SeaFlightGlider/seaflight-mechanical/Parts List.txt

BD-ASY-0348-0000 BUOYANCY ENGINE HYDRAULIC SCHEMATIC
BD-ASY-0360-0000 BUOYANCY ENGINE ASSEMBLY
BD-ASY-0359-0000 RESERVOIR ASSEMLBY
BD-ASY-0357-0000 BUOYANCY ENGINE CHASSIS ASSEMBLY
BD-ASY-0355-0000 MOUNT, FLIGHT WORKS MOTOR
BD-ASY-0354-0000 HOUSING, BLADDER,75 CU IN DISPLACMENT DIAPHRAGM
BD-PRT-0297-0000 CHASSIS, BUOYANCY ENGINE
BD-PRT-0298-0000 ENDCAP, BUOYANCY ENGINE
BD-PRT-0299-0000 HOUSING, BUOYANCY ENGINE
BD-PRT-0300-0000 RESERVOIR CHASSIS, BUOYANCY ENGINE
