SeaFlightGlider/seaflight-mechanical/Step Files/BD-ASY-0359-0002_RevD.stp

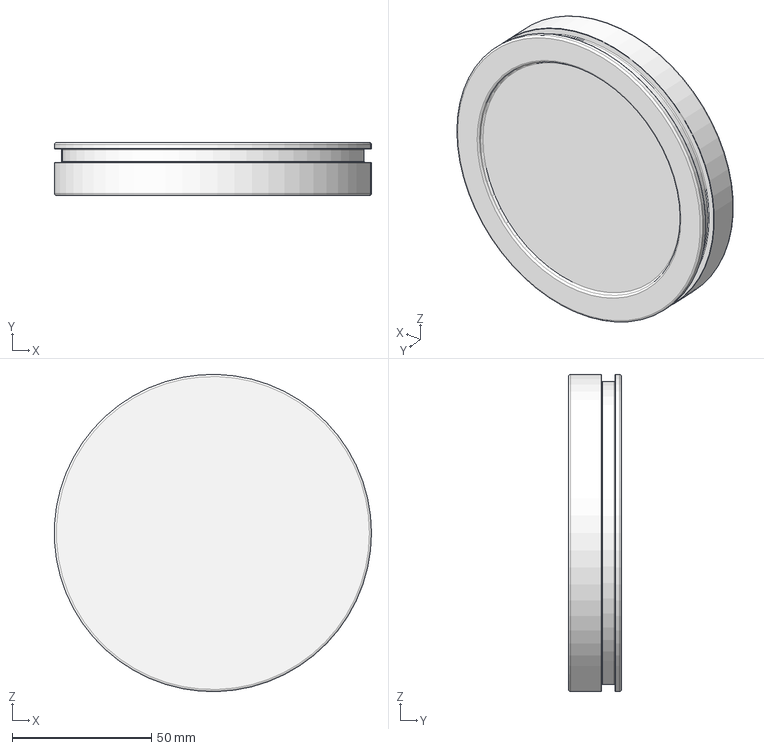
[picture p1: CAD file, 2021-02-25]
Step Files/BD-ASY-0359-0002_RevD.stp
113.8 x 19.1 x 113.9 mm
