SeaFlightGlider/seaflight-mechanical/Step Files/BD-PRT-0308-0000_RevA.stp

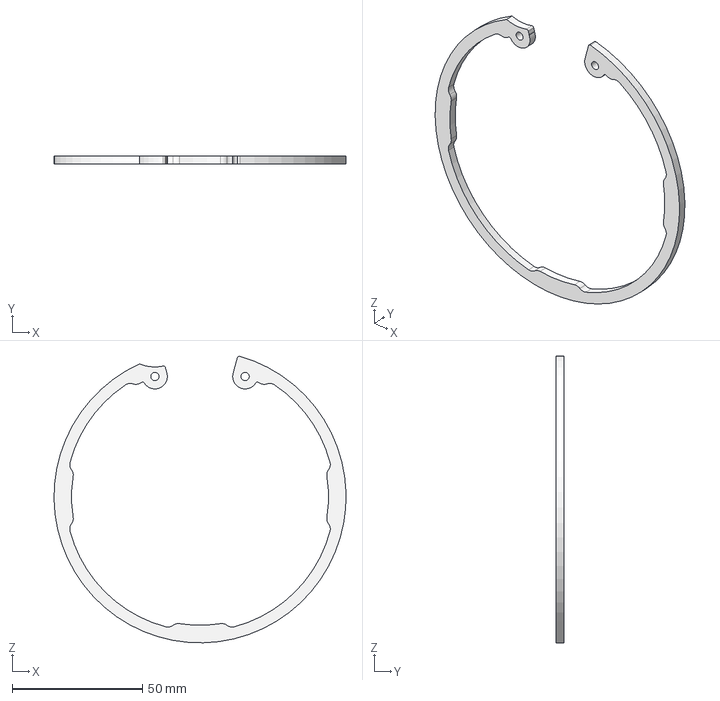
[picture p3: CAD file, 2021-02-25]
Step Files/BD-PRT-0308-0000_RevA.stp
111.9 x 3.17 x 109.9 mm
