SeaFlightGlider/seaflight-mechanical/Step Files/BD-PRT-0297-0000_RevC.stp

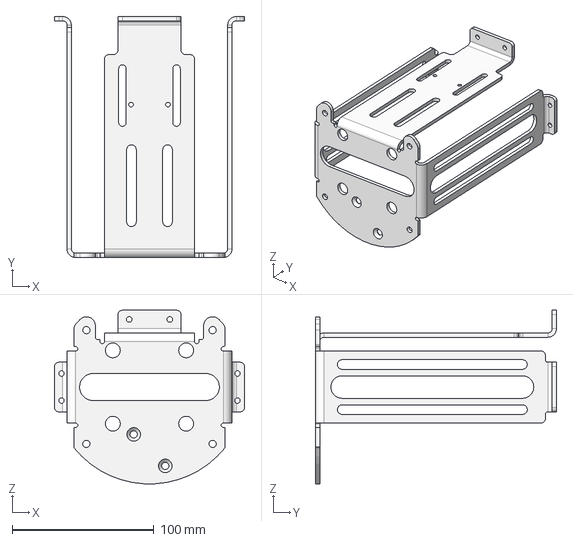
[picture p4: CAD file, 2021-02-25]
Step Files/BD-PRT-0297-0000_RevC.stp
133.9 x 169.7 x 122.2 mm
