SeaFlightGlider/seaflight-mechanical/Step Files/BD-ASY-0354-0001_RevB.stp

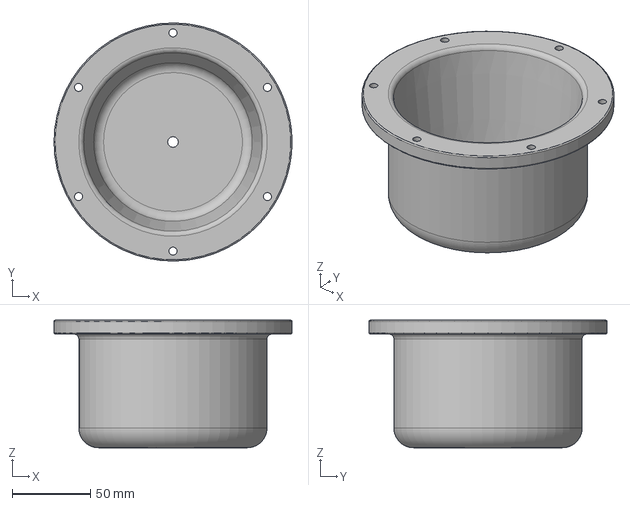
[picture p5: CAD file, 2021-02-25]
Step Files/BD-ASY-0354-0001_RevB.stp
152.4 x 152.4 x 81.7 mm
