SeaFlightGlider/seaflight-mechanical/Step Files/BD-ASY-0359-0001_RevD.stp

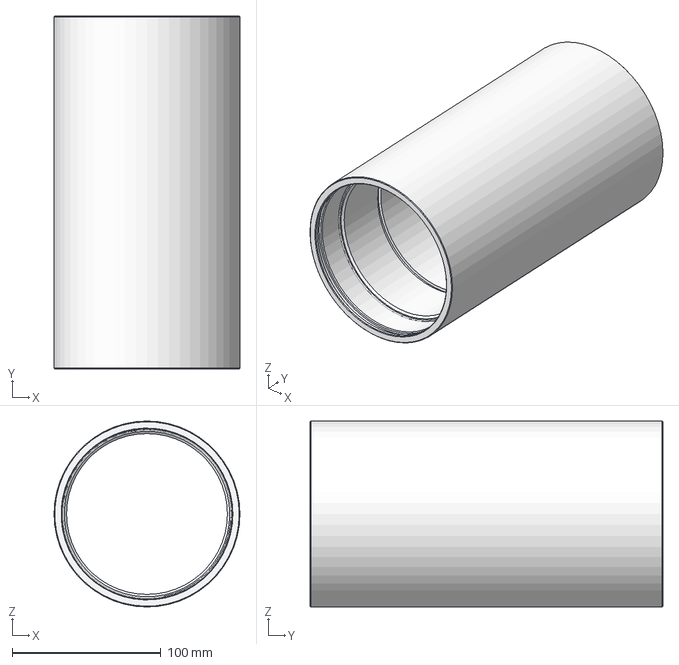
[picture p8: CAD file, 2021-02-25]
Step Files/BD-ASY-0359-0001_RevD.stp
124.8 x 236.9 x 124.8 mm
