SeaFlightGlider/seaflight-mechanical/Step Files/BD-PRT-0299-0000_RevB.stp

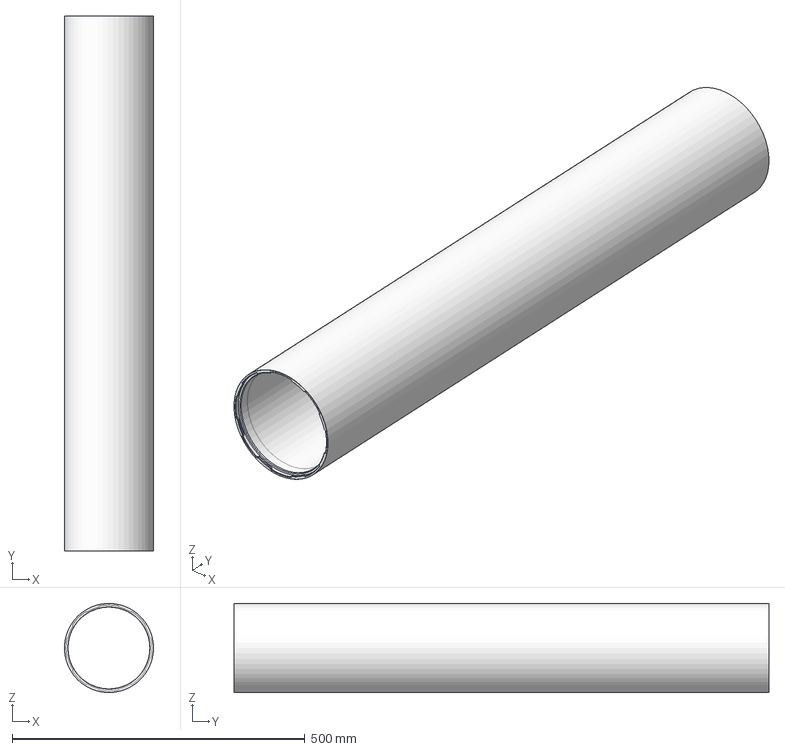
[picture p10: CAD file, 2021-02-25]
Step Files/BD-PRT-0299-0000_RevB.stp
152.3 x 914.4 x 152.3 mm
