SeaFlightGlider/seaflight-mechanical/Step Files/BD-ASY-0355-0001_RevA.stp

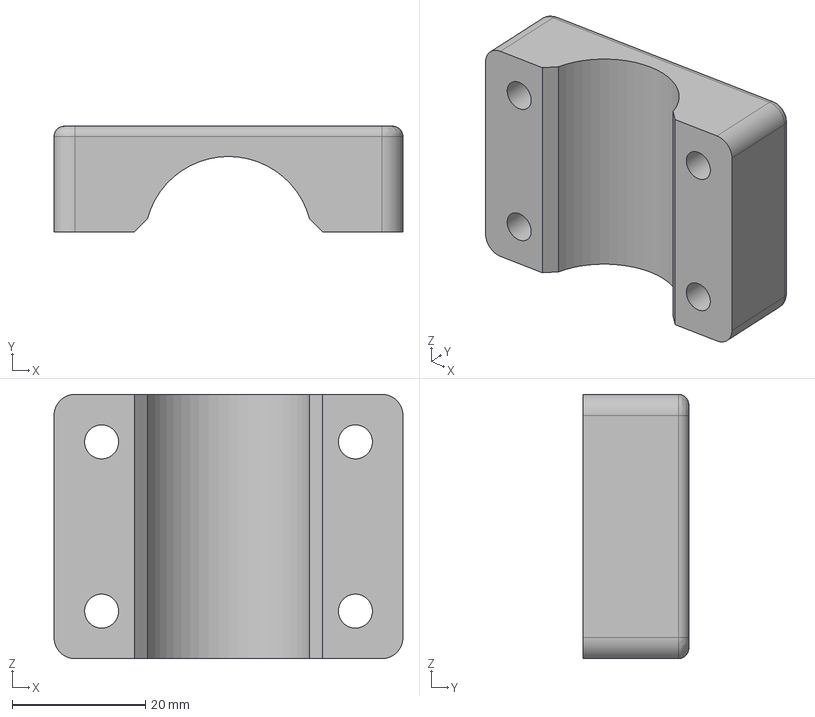
[picture p11: CAD file, 2021-02-25]
Step Files/BD-ASY-0355-0001_RevA.stp
52.4 x 15.9 x 39.7 mm
