SeaFlightGlider/seaflight-mechanical/Step Files/BD-PRT-0307-0000_RevA.stp

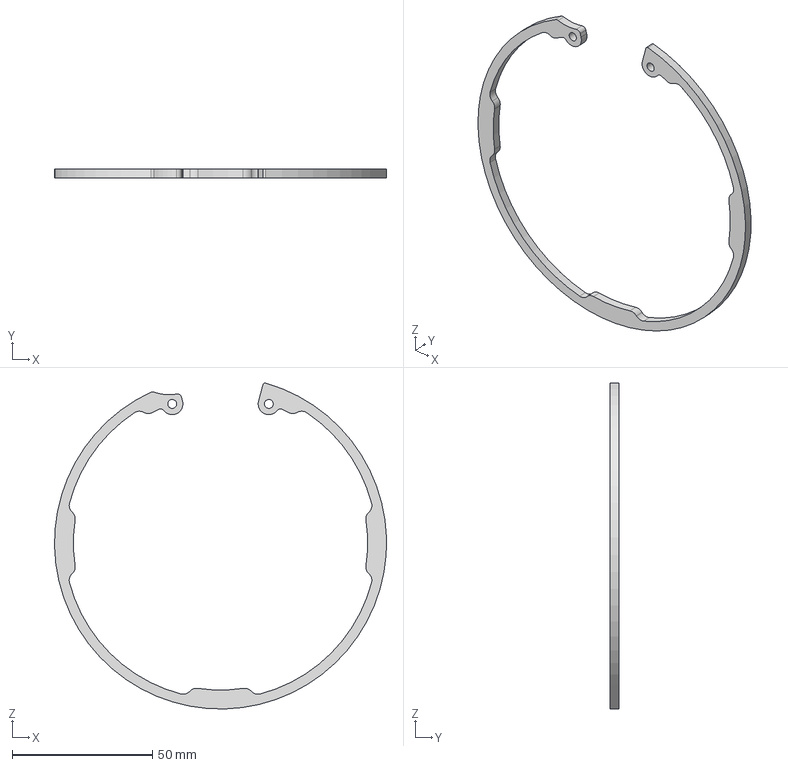
[picture p12: CAD file, 2021-02-25]
Step Files/BD-PRT-0307-0000_RevA.stp
118.3 x 3.17 x 116.1 mm
