SeaFlightGlider/seaflight-mechanical/Step Files/BD-ASY-0359-0003_RevD.stp

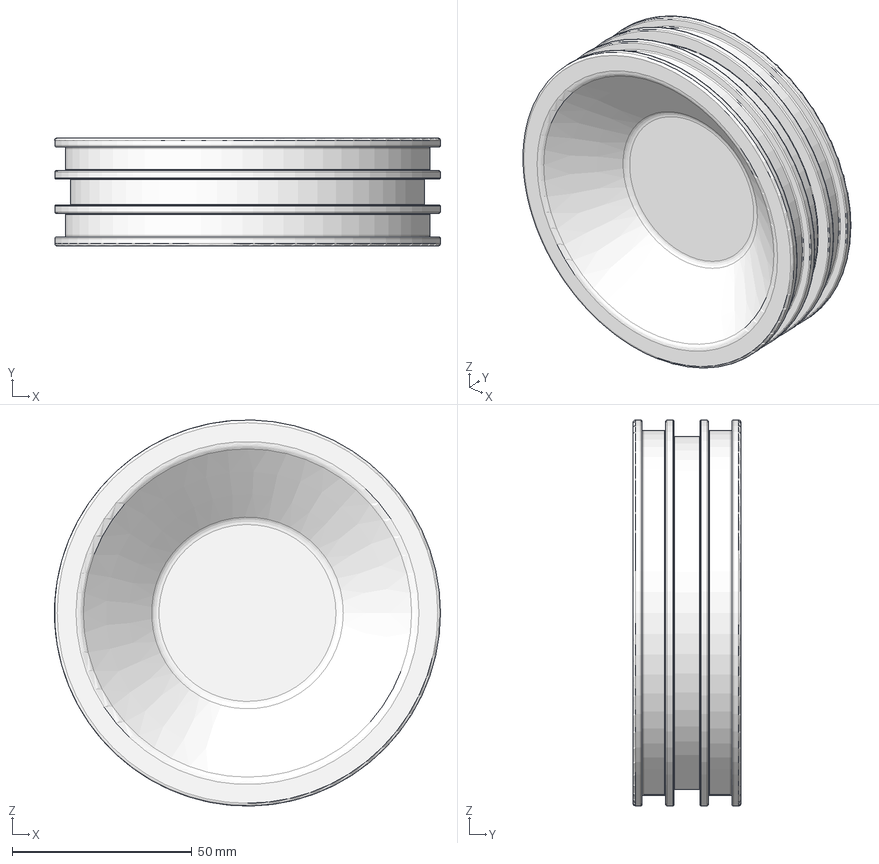
[picture p13: CAD file, 2021-02-25]
Step Files/BD-ASY-0359-0003_RevD.stp
107.5 x 30.2 x 107.5 mm
