SeaFlightGlider/seaflight-mechanical/Step Files/BD-PRT-0298-0002_RevE.stp

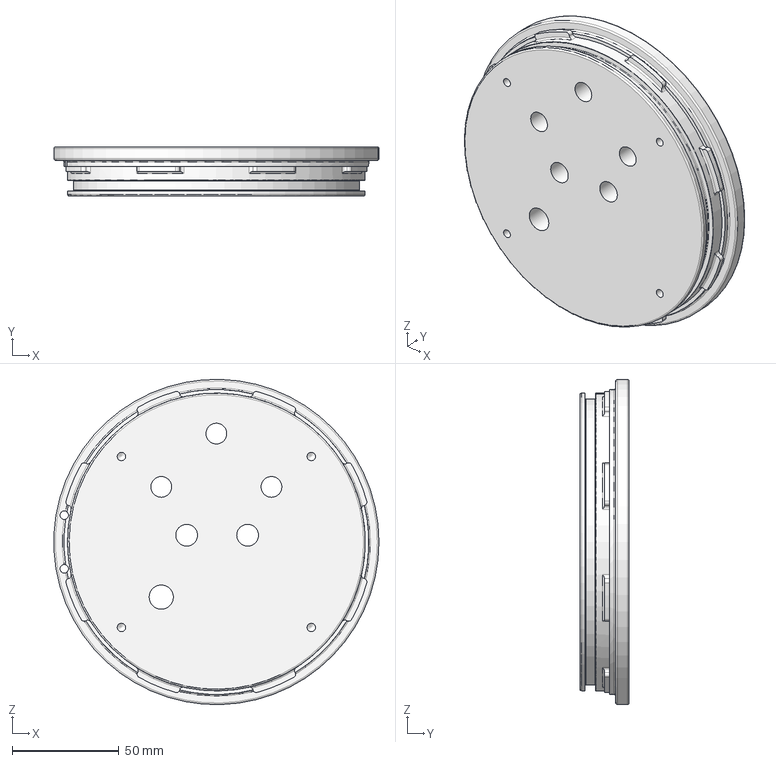
[picture p15: CAD file, 2021-02-25]
Step Files/BD-PRT-0298-0002_RevE.stp
152.3 x 23.2 x 152.3 mm
