SeaFlightGlider/seaflight-mechanical/Step Files/BD-PRT-0300-0000_RevB.stp

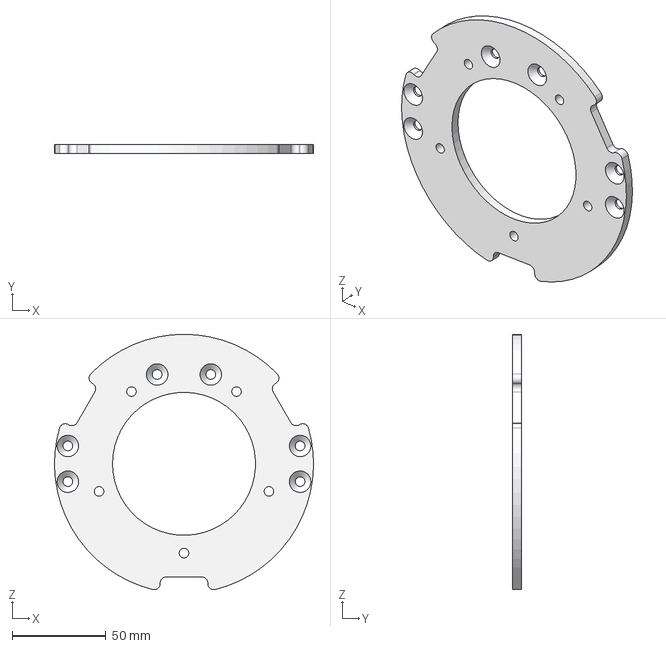
[picture p16: CAD file, 2021-02-25]
Step Files/BD-PRT-0300-0000_RevB.stp
138.1 x 4.76 x 136.2 mm
