SeaFlightGlider/seaflight-mechanical/(list of files, cad)

Other CAD files:
Step Files/BD-PRT-0307-0000_RevA.dxf
Step Files/BD-PRT-0308-0000_RevA.dxf
