SeaFlightGlider/seaflight-mechanical/BD-ASY-0348-0000_RevC.pdf

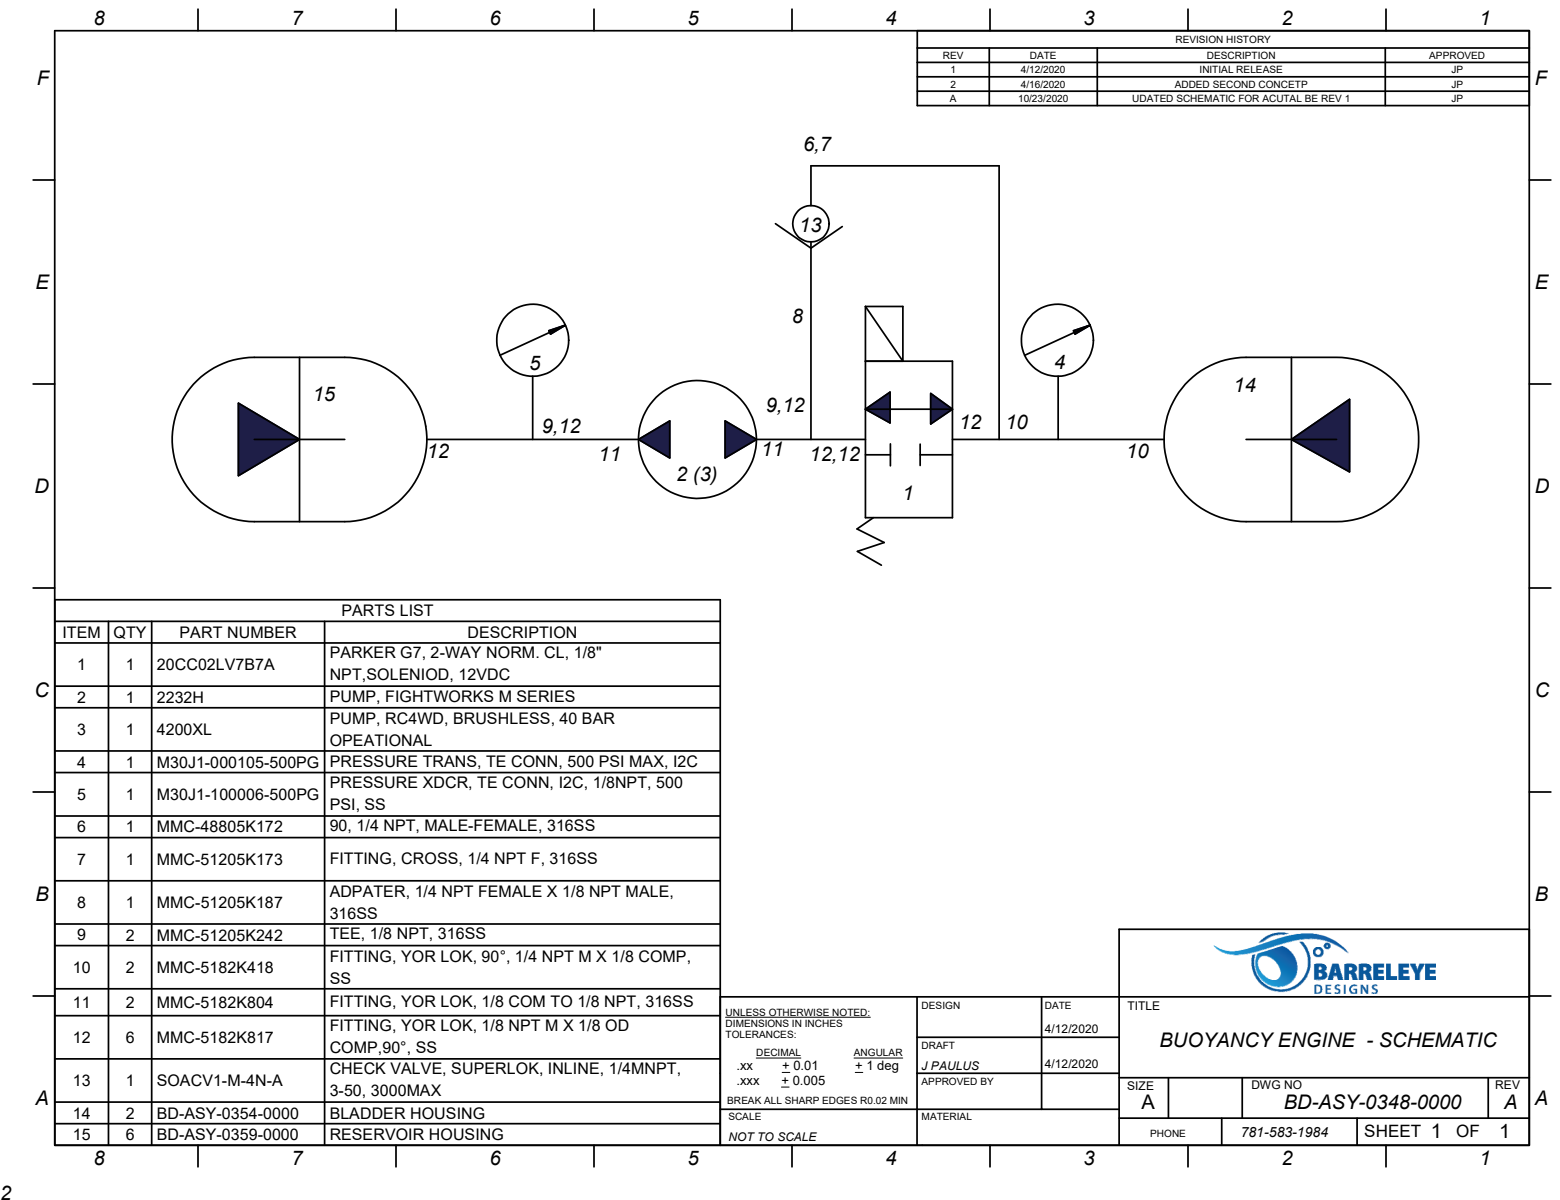
[picture p17: page 1]
DESIGN; DECIMAL; ANGULAR; + 1 deg; DATE; PARTS LIST; REVISION HISTORY

REV | DATE | DESCRIPTION | APPROVED
1 | 4/12/2020 | INITIAL RELEASE | JP
2 | 4/16/2020 | ADDED SECOND CONCETP | JP
A | 10/23/2020 | UDATED SCHEMATIC FOR ACUTAL BE REV 1 | JP

ITEM | QTY | PART NUMBER | DESCRIPTION
1 | 1 | 20CC02LV7B7A | PARKER G7, 2-WAY NORM. CL, 1/8" NPT,SOLENIOD, 12VDC

2 | 1 | 2232H | PUMP, FIGHTWORKS M SERIES
3 | 1 | 4200XL | PUMP, RC4WD, BRUSHLESS, 40 BAR OPEATIONAL

4 | 1 | M30J1-000105-500PG | PRESSURE TRANS, TE CONN, 500 PSI MAX, I2C
5 | 1 | M30J1-100006-500PG | PRESSURE XDCR, TE CONN, I2C, 1/8NPT, 500 PSI, SS

6 | 1 | MMC-48805K172 | 90, 1/4 NPT, MALE-FEMALE, 316SS
7 | 1 | MMC-51205K173 | FITTING, CROSS, 1/4 NPT F, 316SS
8 | 1 | MMC-51205K187 | ADPATER, 1/4 NPT FEMALE X 1/8 NPT MALE, 316SS

9 | 2 | MMC-51205K242 | TEE, 1/8 NPT, 316SS
10 | 2 | MMC-5182K418 | FITTING, YOR LOK, 90°, 1/4 NPT M X 1/8 COMP, SS

11 | 2 | MMC-5182K804 | FITTING, YOR LOK, 1/8 COM TO 1/8 NPT, 316SS

UNLESS OTHERWISE NOTED:

TITLE
BUOYANCY ENGINE - SCHEMATIC

12 | 6 | MMC-5182K817 | FITTING, YOR LOK, 1/8 NPT M X 1/8 OD COMP,90°, SS | DIMENSIONS IN INCHES TOLERANCES: .xxx + 0.005 BREAK ALL SHARP EDGES R0.02 MIN

DRAFT J PAULUS | 4/12/2020

13 | 1 | SOACV1-M-4N-A | CHECK VALVE, SUPERLOK, INLINE, 1/4MNPT, 3-50, 3000MAX

APPROVED BY | | SIZE A | DWG NO BD-ASY-0348-0000 | REV A

14 | 2 | BD-ASY-0354-0000 | BLADDER HOUSING
15 | 6 | BD-ASY-0359-0000 | RESERVOIR HOUSING

SCALE NOT TO SCALE | MATERIAL
PHONE | 781-583-1984 | SHEET 1 OF 1
