SeaFlightGlider/seaflight-mechanical/BD-ASY-0354-0000_RevB.pdf

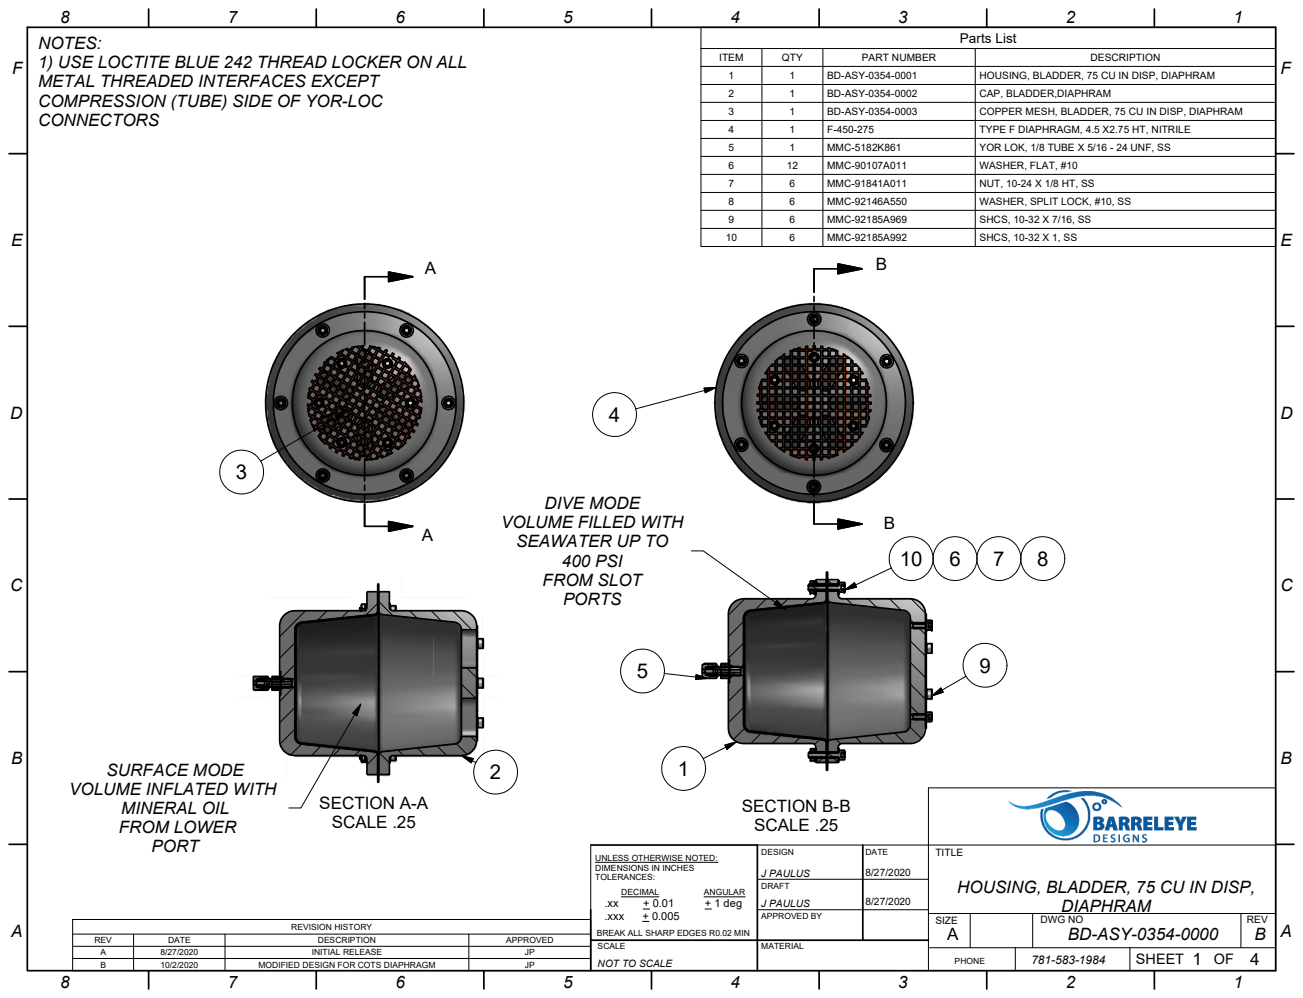
[picture p18: page 1]
SECTION A-A SCALE .25; SECTION B-B SCALE .25; SHEET; DESIGN; DECIMAL; ANGULAR; + 1 deg; .xxx; MATERIAL; DATE; DIAPHRAM; J PAULUS; NOT TO SCALE; PHONE; Parts List; REVISION HISTORY; INITIAL RELEASE; MODIFIED DESIGN FOR COTS DIAPHRAGM

NOTES:
1) USE LOCTITE BLUE 242 THREAD LOCKER ON ALL
METAL THREADED INTERFACES EXCEPT
COMPRESSION (TUBE) SIDE OF YOR-LOC
CONNECTORS

ITEM | QTY | PART NUMBER | DESCRIPTION
1 | 1 | BD-ASY-0354-0001 | HOUSING, BLADDER, 75 CU IN DISP, DIAPHRAM
2 | 1 | BD-ASY-0354-0002 | CAP, BLADDER,DIAPHRAM
3 | 1 | BD-ASY-0354-0003 | COPPER MESH, BLADDER, 75 CU IN DISP, DIAPHRAM
4 | 1 | F-450-275 | TYPE F DIAPHRAGM, 4.5 X2.75 HT, NITRILE
5 | 1 | MMC-5182K861 | YOR LOK, 1/8 TUBE X 5/16 - 24 UNF, SS
6 | 12 | MMC-90107A011 | WASHER, FLAT, #10
7 | 6 | MMC-91841A011 | NUT, 10-24 X 1/8 HT, SS
8 | 6 | MMC-92146A550 | WASHER, SPLIT LOCK, #10, SS
9 | 6 | MMC-92185A969 | SHCS, 10-32 X 7/16, SS
10 | 6 | MMC-92185A992 | SHCS, 10-32 X 1, SS

DIVE MODE
VOLUME FILLED WITH
SEAWATER UP TO
400 PSI
FROM SLOT
PORTS

SURFACE MODE
VOLUME INFLATED WITH
MINERAL OIL
FROM LOWER
PORT

UNLESS OTHERWISE NOTED:
DIMENSIONS IN INCHES
TOLERANCES:

TITLE
HOUSING, BLADDER, 75 CU IN DISP,

DRAFT J PAULUS | 8/27/2020

APPROVED BY | | SIZE A | DWG NO BD-ASY-0354-0000 | REV B

REV | DATE | DESCRIPTION | APPROVED

BREAK ALL SHARP EDGES R0.02 MIN
SCALE

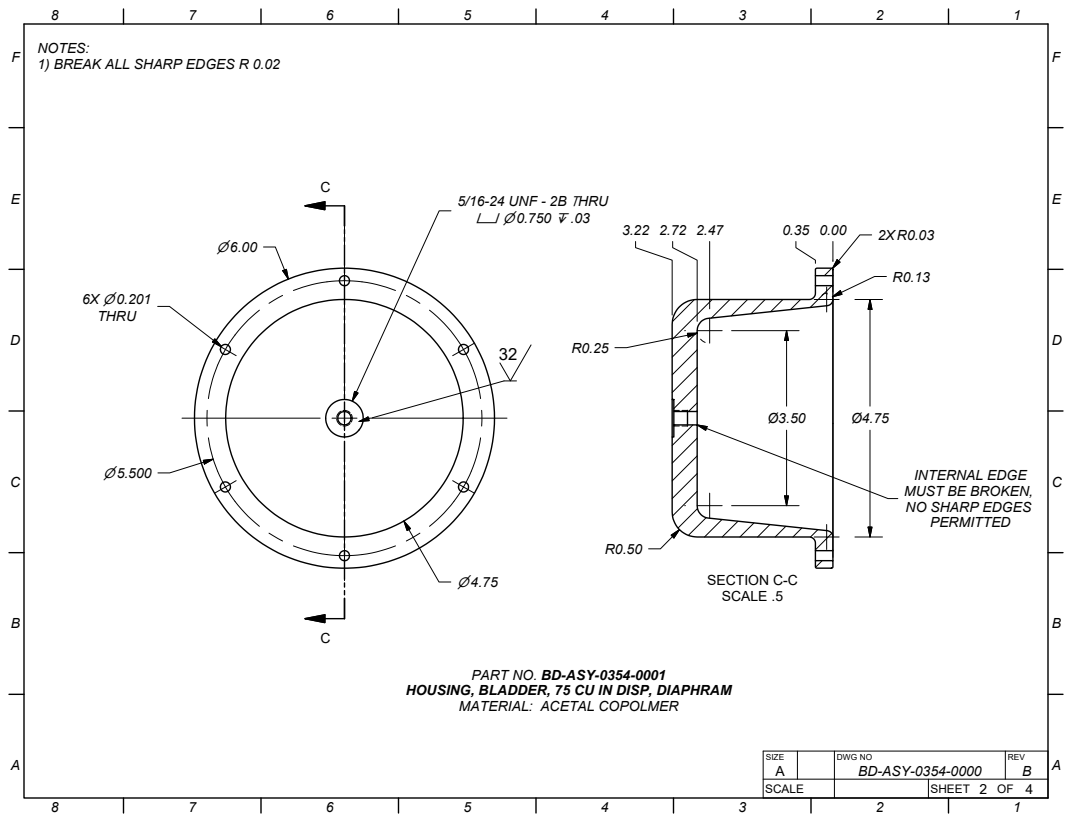
[picture p19: page 2]
SECTION C-C SCALE .5; 5/16-24 UNF - 2B HRU 0.750 .03; 6X 0.201 THRU

1) BREAK ALL SHARP EDGES R 0.02

INTERNAL EDGE
MUST BE BROKEN,
NO SHARP EDGES
PERMITTED

PART NO. BD-ASY-0354-0001

HOUSING, BLADDER, 75 CU IN DISP, DIAPHRAM

MATERIAL: ACETAL COPOLMER

SIZE | DWG NO | REV

SCALE | SHEET OF

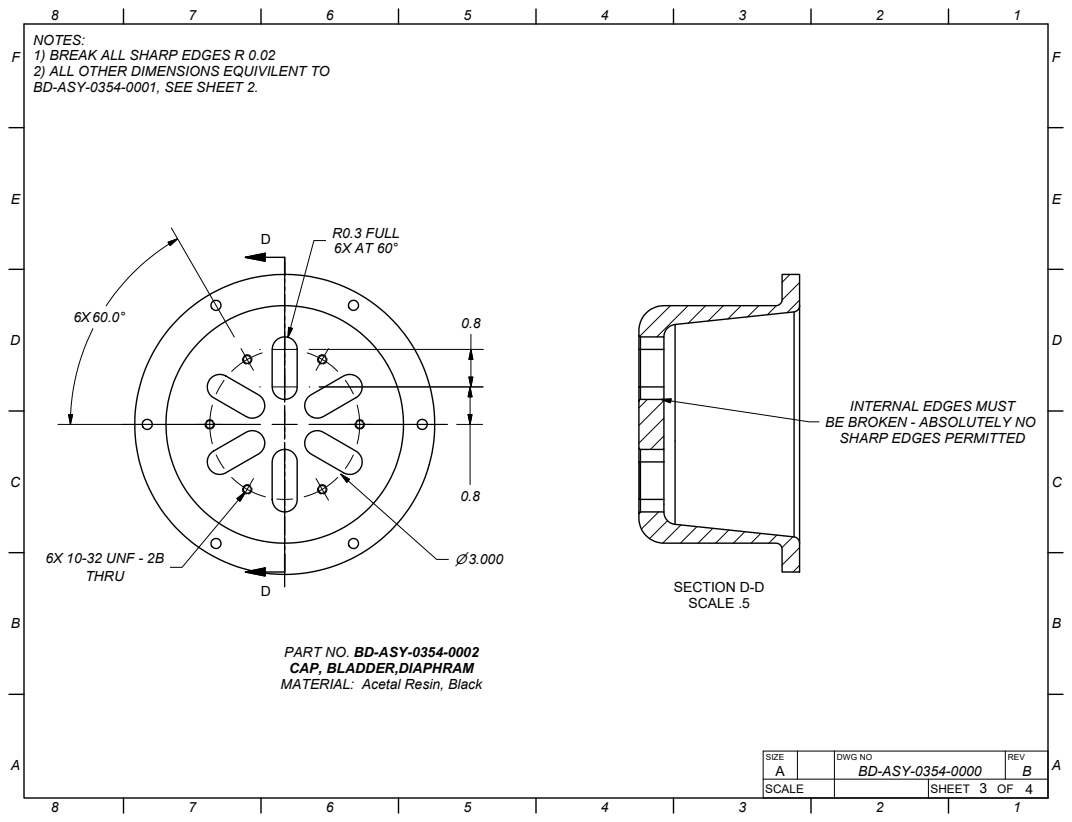
[picture p20: page 3]
SECTION D-D SCALE .5; SIZE; DWG NO; REV; R0.3 FULL 6X AT 60°; 6X 10-32 UNF - 2B; THRU

1) BREAK ALL SHARP EDGES R 0.02
2) ALL OTHER DIMENSIONS EQUIVILENT TO
BD-ASY-0354-0001, SEE SHEET 2.

INTERNAL EDGES MUST
BE BROKEN - ABSOLUTELY NO
SHARP EDGES PERMITTED

PART NO. BD-ASY-0354-0002
CAP, BLADDER,DIAPHRAM
MATERIAL: Acetal Resin, Black

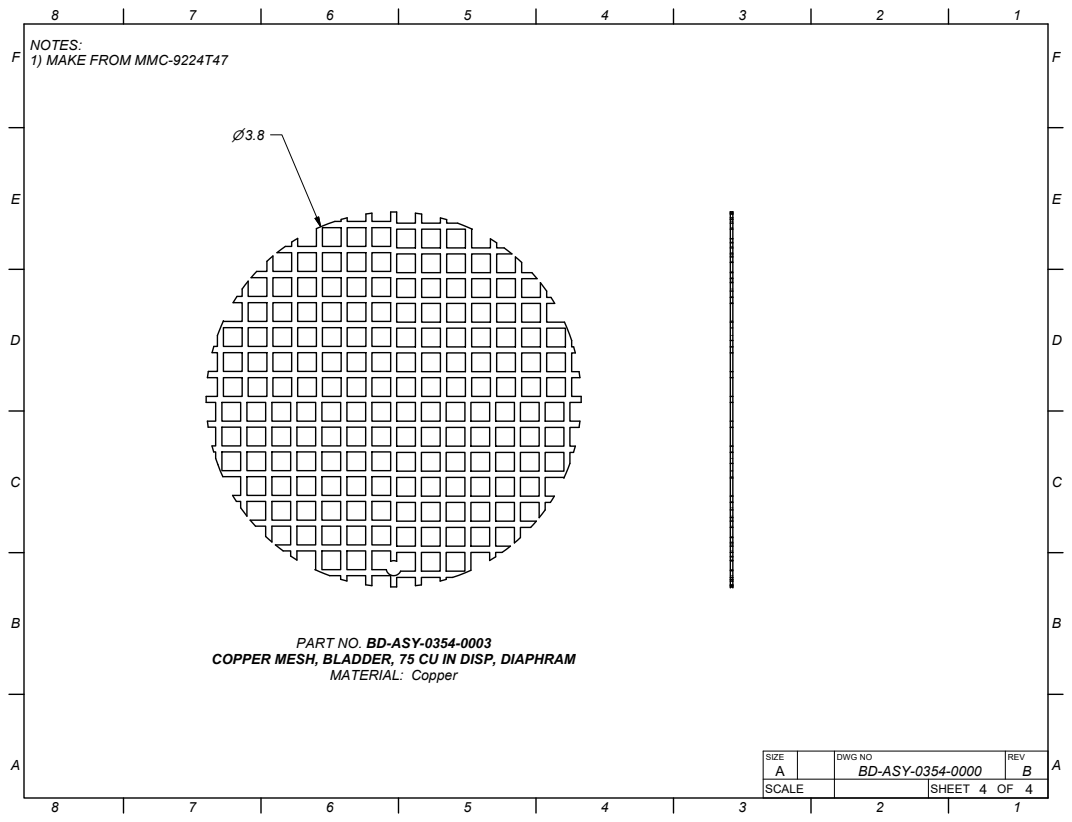
[picture p21: page 4]
MATERIAL: Copper; SIZE; DWG NO; REV

1) MAKE FROM MMC-9224T47

PART NO. BD-ASY-0354-0003

COPPER MESH, BLADDER, 75 CU IN DISP, DIAPHRAM
