SeaFlightGlider/seaflight-mechanical/BD-ASY-0355-0000_RevA.pdf

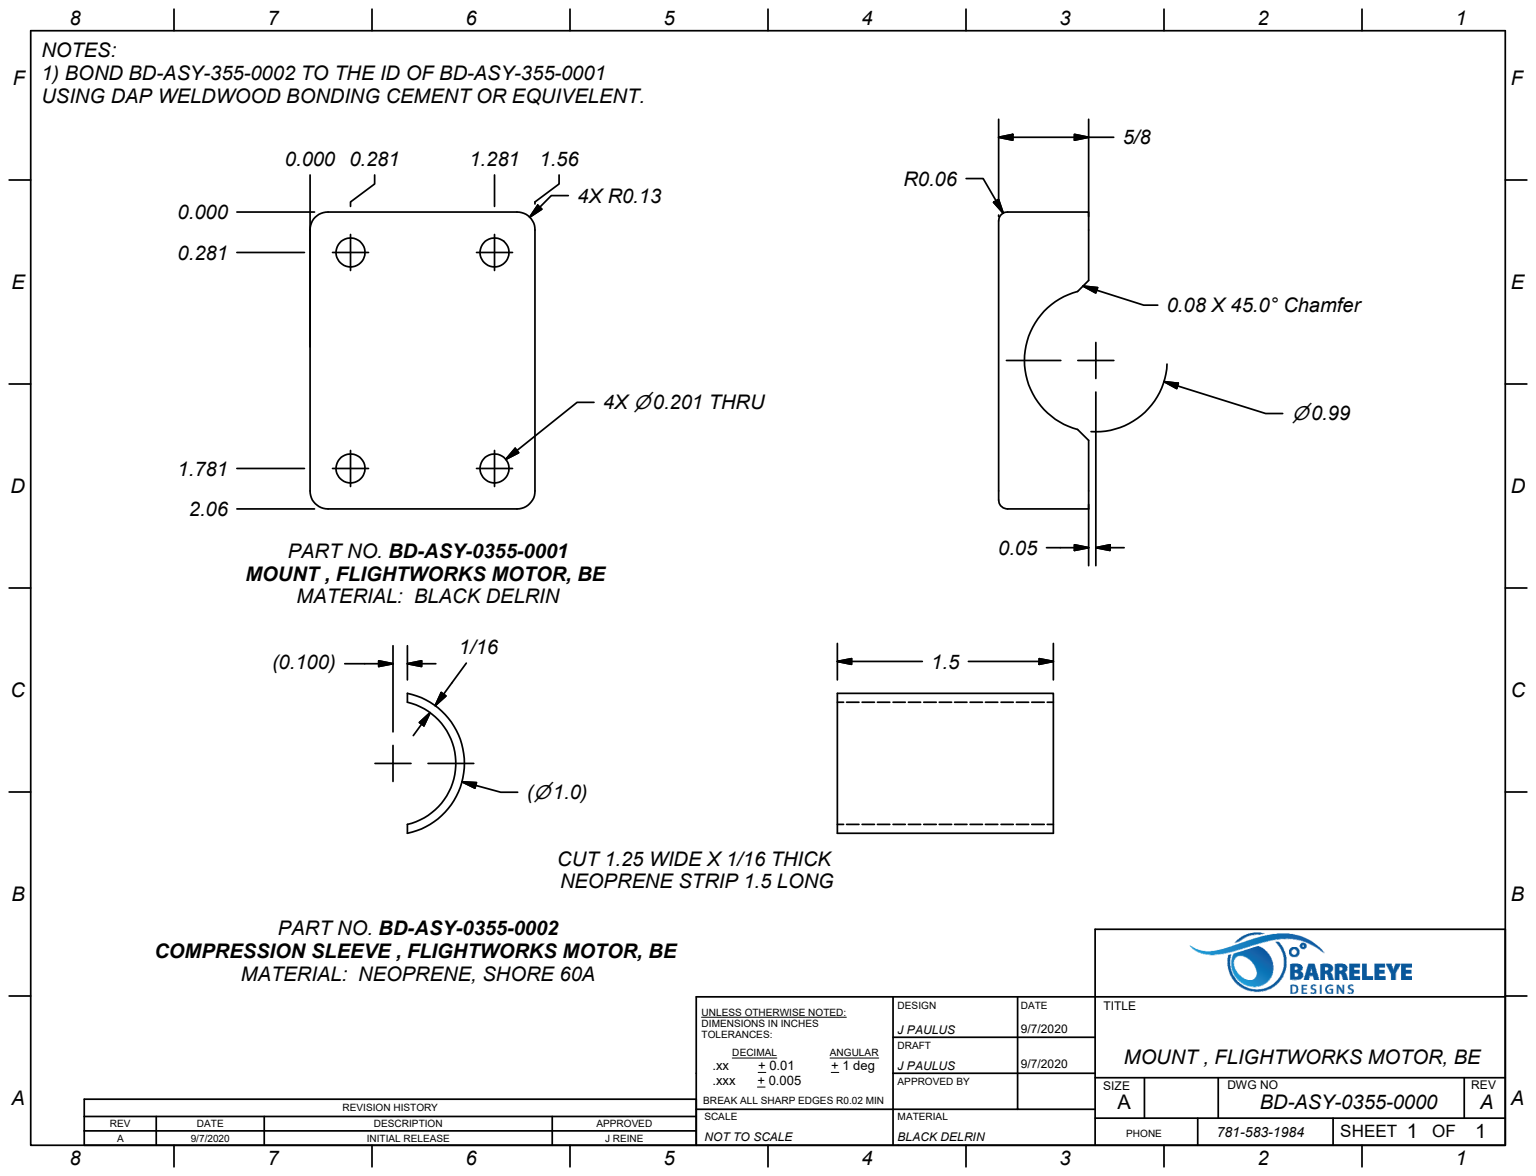
[picture p22: page 1]
SHEET; DESIGN; TITLE; DECIMAL; ANGULAR; + 1 deg; .xxx; MATERIAL; DATE; J PAULUS; BLACK DELRIN; NOT TO SCALE; PHONE; REVISION HISTORY; REV; DESCRIPTION; APPROVED; INITIAL RELEASE; J REINE; 0.08 X 45.0° Chamfer; THRU 0.201

NOTES:
1) BOND BD-ASY-355-0002 TO THE ID OF BD-ASY-355-0001
USING DAP WELDWOOD BONDING CEMENT OR EQUIVELENT.

PART NO. BD-ASY-0355-0001
MOUNT , FLIGHTWORKS MOTOR, BE
MATERIAL: BLACK DELRIN

CUT 1.25 WIDE X 1/16 THICK
NEOPRENE STRIP 1.5 LONG

PART NO. BD-ASY-0355-0002

COMPRESSION SLEEVE , FLIGHTWORKS MOTOR, BE

MATERIAL: NEOPRENE, SHORE 60A

UNLESS OTHERWISE NOTED:
DIMENSIONS IN INCHES
TOLERANCES:

DRAFT J PAULUS | 9/7/2020

APPROVED BY | | SIZE A | DWG NO BD-ASY-0355-0000 | REV A

BREAK ALL SHARP EDGES R0.02 MIN
SCALE
