SeaFlightGlider/seaflight-mechanical/BD-ASY-0357-0000_RevC.pdf

1

2

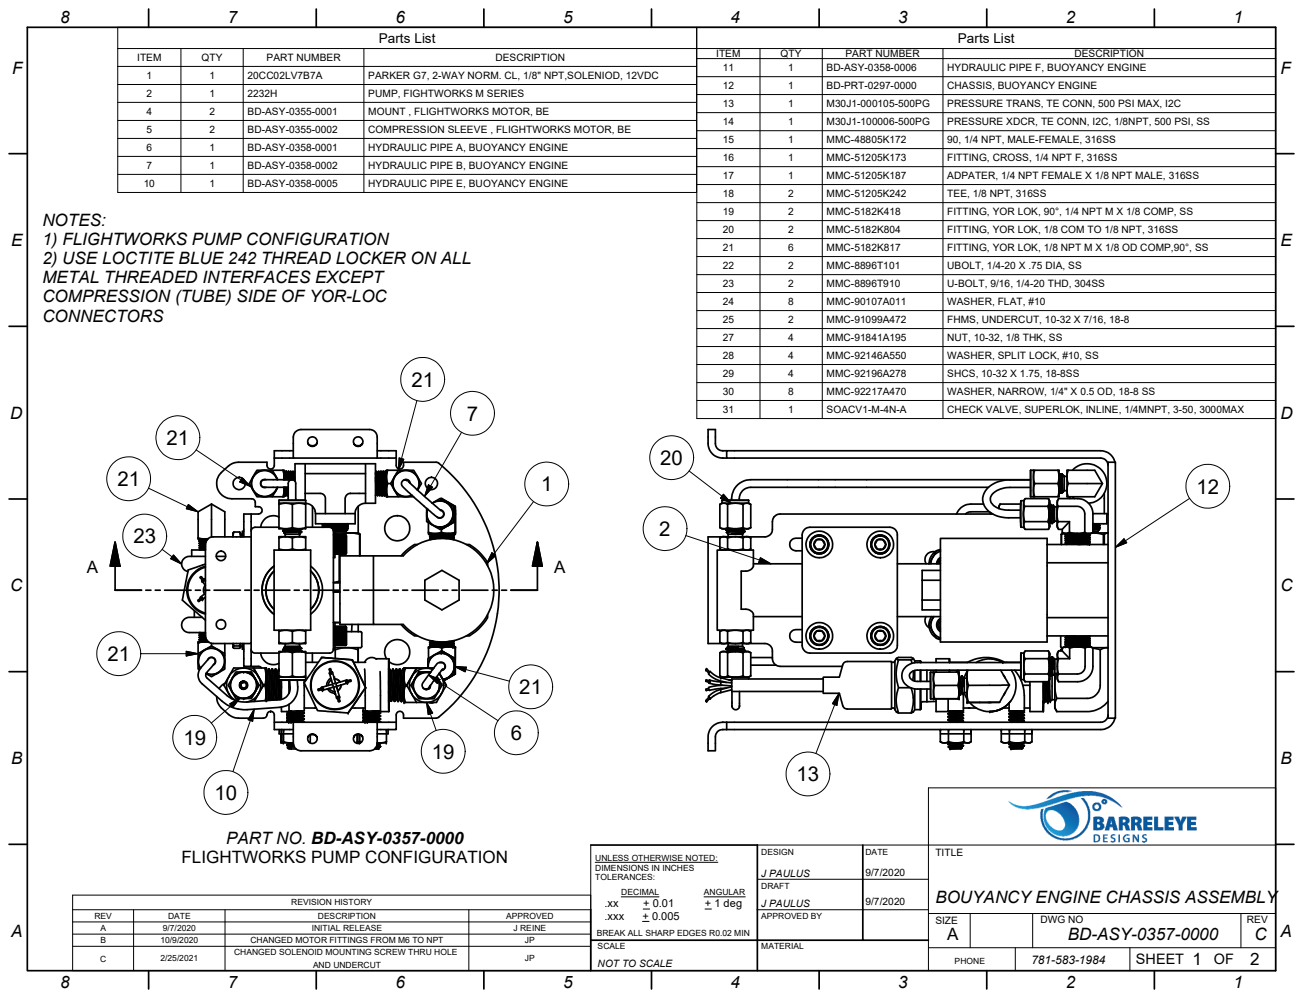
[picture p23: page 1]
SIZE; DWG NO; REV; SHEET; DESIGN; APPROVED BY; TITLE; DRAFT; DECIMAL; ANGULAR; + 1 deg; .xxx; MATERIAL; DATE; BD-ASY-0357-0000; J PAULUS; NOT TO SCALE; PHONE; Parts List; ITEM; QTY; PART NUMBER; DESCRIPTION; PARKER G7, 2-WAY NORM. CL, 1/8" NPT,SOLENIOD, 12VDC; PUMP, FIGHTWORKS M SERIES; BD-ASY-0355-0001; MOUNT , FLIGHTWORKS MOTOR, BE; BD-ASY-0355-0002; COMPRESSION SLEEVE , FLIGHTWORKS MOTOR, BE; BD-ASY-0358-0001; HYDRAULIC PIPE A, BUOYANCY ENGINE; BD-ASY-0358-0002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

NOTES:
1) FLIGHTWORKS PUMP CONFIGURATION
2) USE LOCTITE BLUE 242 THREAD LOCKER ON ALL
METAL THREADED INTERFACES EXCEPT
COMPRESSION (TUBE) SIDE OF YOR-LOC
CONNECTORS

PART NO. BD-ASY-0357-0000
FLIGHTWORKS PUMP CONFIGURATION

UNLESS OTHERWISE NOTED:
DIMENSIONS IN INCHES
TOLERANCES:

BOUYANCY ENGINE CHASSIS ASSEMBLY

BREAK ALL SHARP EDGES R0.02 MIN
SCALE

## SECTION A-A

SCALE .5 | SECTION B-B

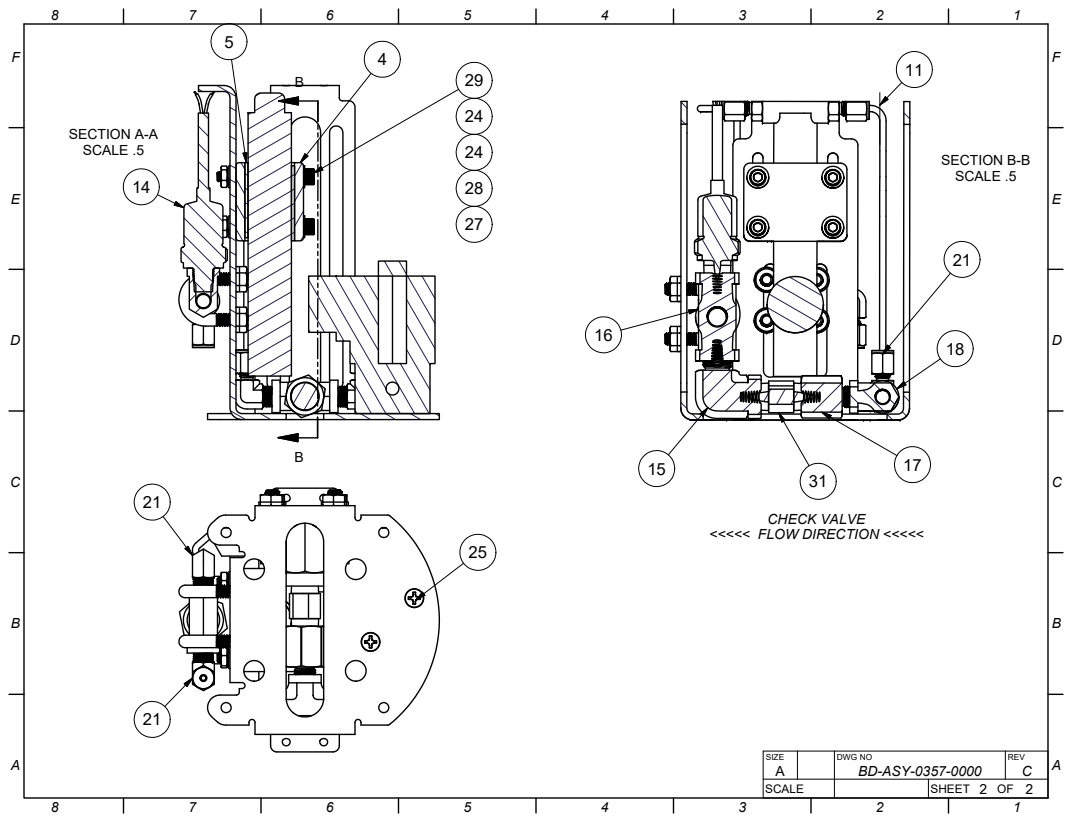
[picture p24: page 2]
SCALE .5; SIZE; DWG NO; REV; SCALE; SHEET; BD-ASY-0357-0000; CHECK VALVE <<<<< FLOW DIRECTION <<<<<
