SeaFlightGlider/seaflight-mechanical/BD-ASY-0359-0000_RevD.pdf

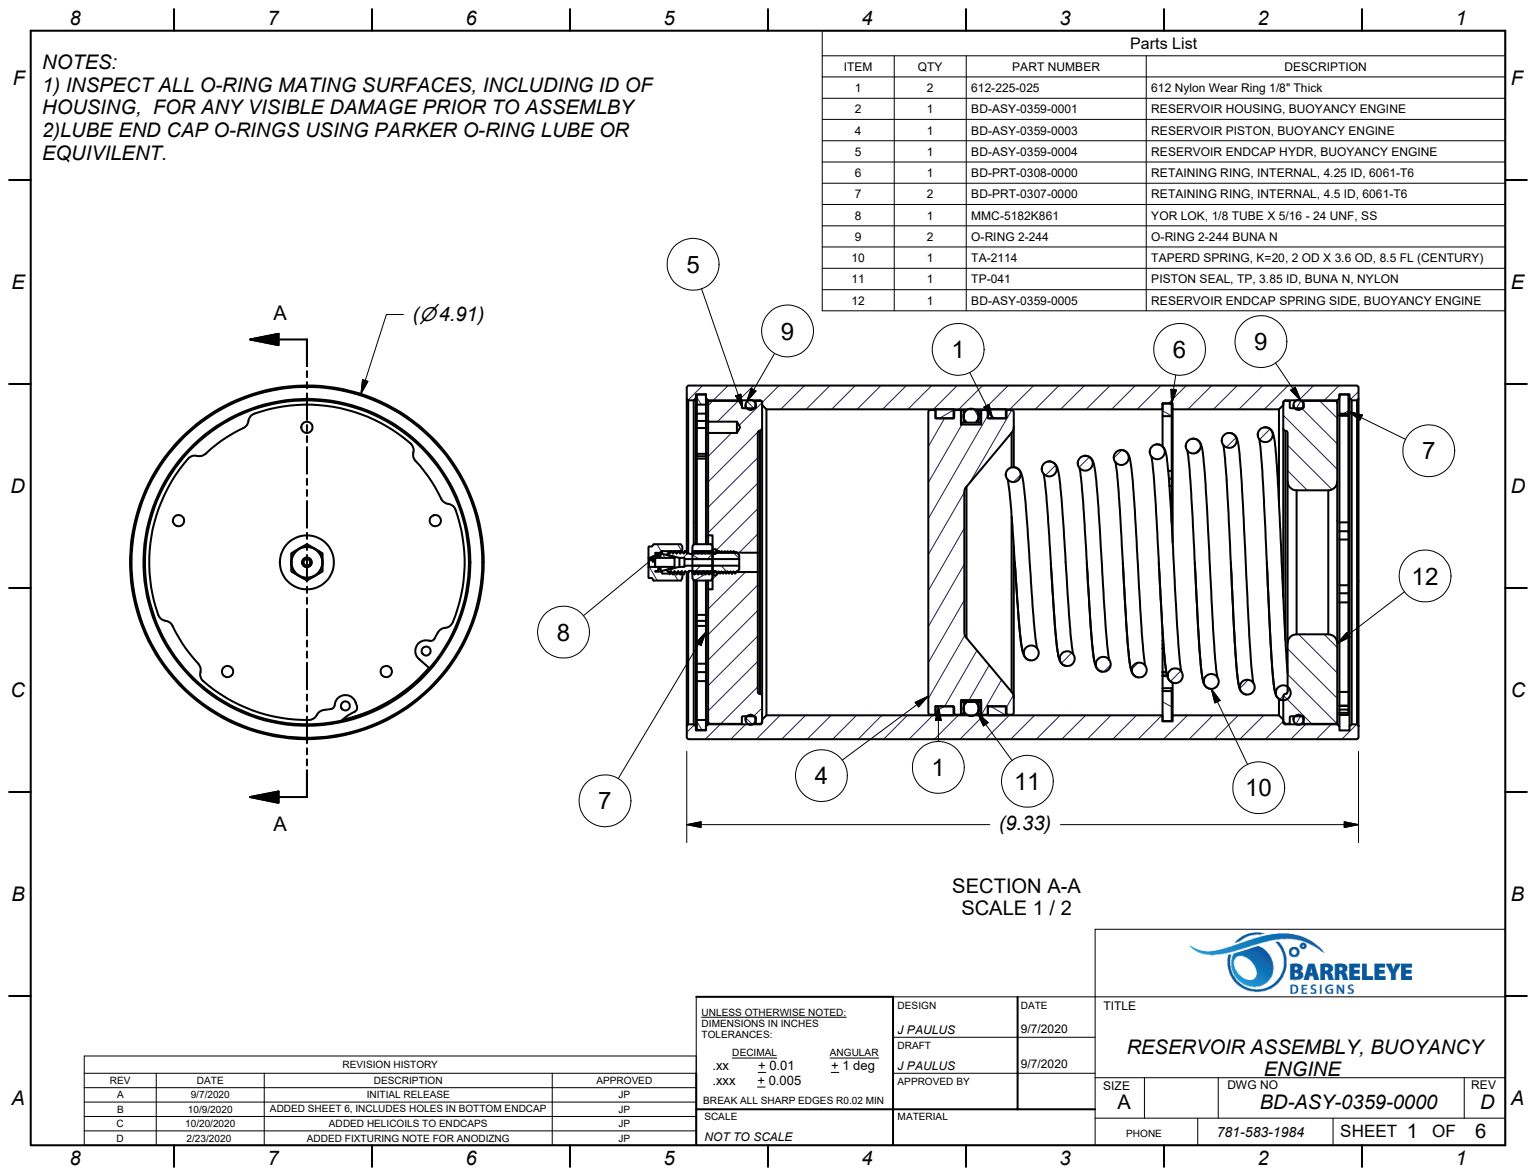
[picture p25: page 1]
SECTION A-A SCALE 1 / 2; SIZE; DWG NO; REV; SHEET; DESIGN; APPROVED BY; DRAFT; DECIMAL; ANGULAR; + 1 deg; .xxx; MATERIAL; DATE; ENGINE BD-ASY-0359-0000; J PAULUS; NOT TO SCALE; PHONE; Parts List; BD-ASY-0359-0005; RESERVOIR ENDCAP SPRING SIDE, BUOYANCY ENGINE ( 4.91); REVISION HISTORY; DESCRIPTION; APPROVED; ADDED HELICOILS TO ENDCAPS; ADDED FIXTURING NOTE FOR ANODIZNG

NOTES:
1) INSPECT ALL O-RING MATING SURFACES, INCLUDING ID OF
HOUSING, FOR ANY VISIBLE DAMAGE PRIOR TO ASSEMLBY
2)LUBE END CAP O-RINGS USING PARKER O-RING LUBE OR
EQUIVILENT.

ITEM | QTY | PART NUMBER | DESCRIPTION
1 | 2 | 612-225-025 | 612 Nylon Wear Ring 1/8" Thick
2 | 1 | BD-ASY-0359-0001 | RESERVOIR HOUSING, BUOYANCY ENGINE
4 | 1 | BD-ASY-0359-0003 | RESERVOIR PISTON, BUOYANCY ENGINE
5 | 1 | BD-ASY-0359-0004 | RESERVOIR ENDCAP HYDR, BUOYANCY ENGINE
6 | 1 | BD-PRT-0308-0000 | RETAINING RING, INTERNAL, 4.25 ID, 6061-T6
7 | 2 | BD-PRT-0307-0000 | RETAINING RING, INTERNAL, 4.5 ID, 6061-T6
8 | 1 | MMC-5182K861 | YOR LOK, 1/8 TUBE X 5/16 - 24 UNF, SS
9 | 2 | O-RING 2-244 | O-RING 2-244 BUNA N
10 | 1 | TA-2114 | TAPERD SPRING, K=20, 2 OD X 3.6 OD, 8.5 FL (CENTURY)
11 | 1 | TP-041 | PISTON SEAL, TP, 3.85 ID, BUNA N, NYLON

UNLESS OTHERWISE NOTED:
DIMENSIONS IN INCHES
TOLERANCES:

TITLE
RESERVOIR ASSEMBLY, BUOYANCY

A | 9/7/2020 | INITIAL RELEASE | JP
B | 10/9/2020 | ADDED SHEET 6, INCLUDES HOLES IN BOTTOM ENDCAP | JP

BREAK ALL SHARP EDGES R0.02 MIN
SCALE

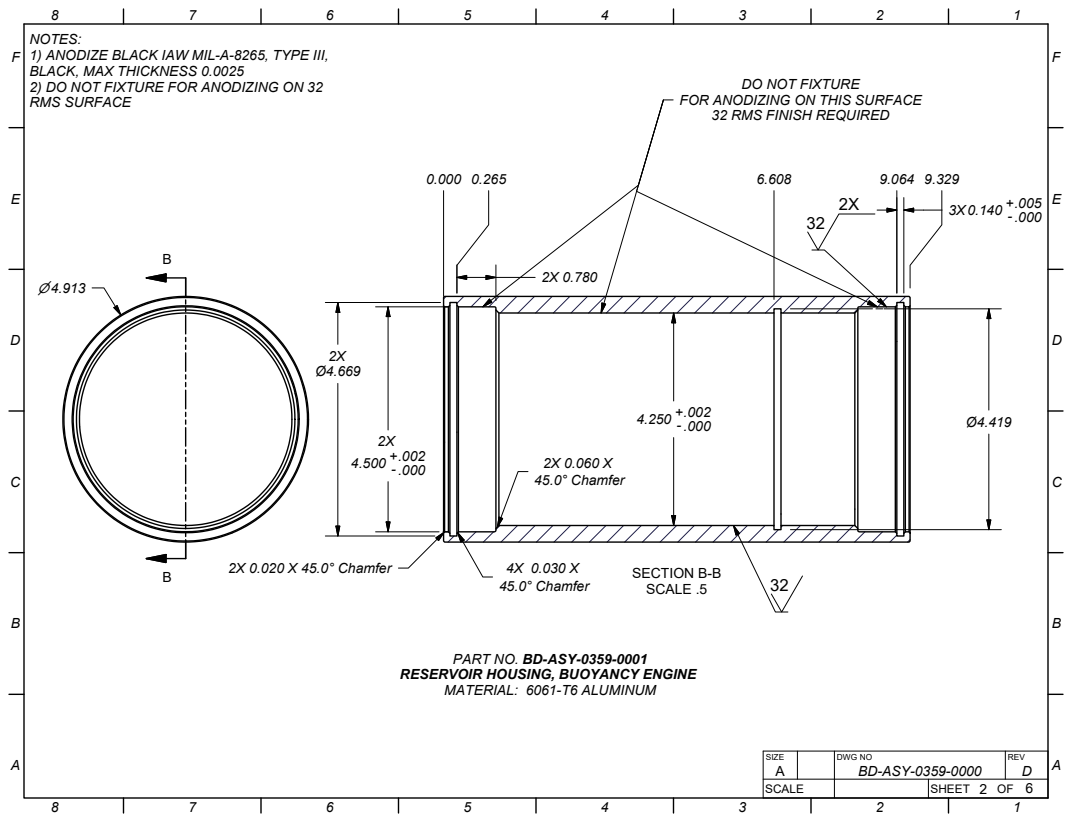
[picture p26: page 2]
SECTION B-B SCALE .5; 2X 0.060 X 45.0° Chamfer; 4X 0.030 X 45.0° Chamfer; 2X 0.020 X 45.0° Chamfer

1) ANODIZE BLACK IAW MIL-A-8265, TYPE III,
BLACK, MAX THICKNESS 0.0025
2) DO NOT FIXTURE FOR ANODIZING ON 32
RMS SURFACE

DO NOT FIXTURE

FOR ANODIZING ON THIS SURFACE
32 RMS FINISH REQUIRED

PART NO. BD-ASY-0359-0001

RESERVOIR HOUSING, BUOYANCY ENGINE
MATERIAL: 6061-T6 ALUMINUM

SIZE | DWG NO | REV

SCALE | SHEET OF

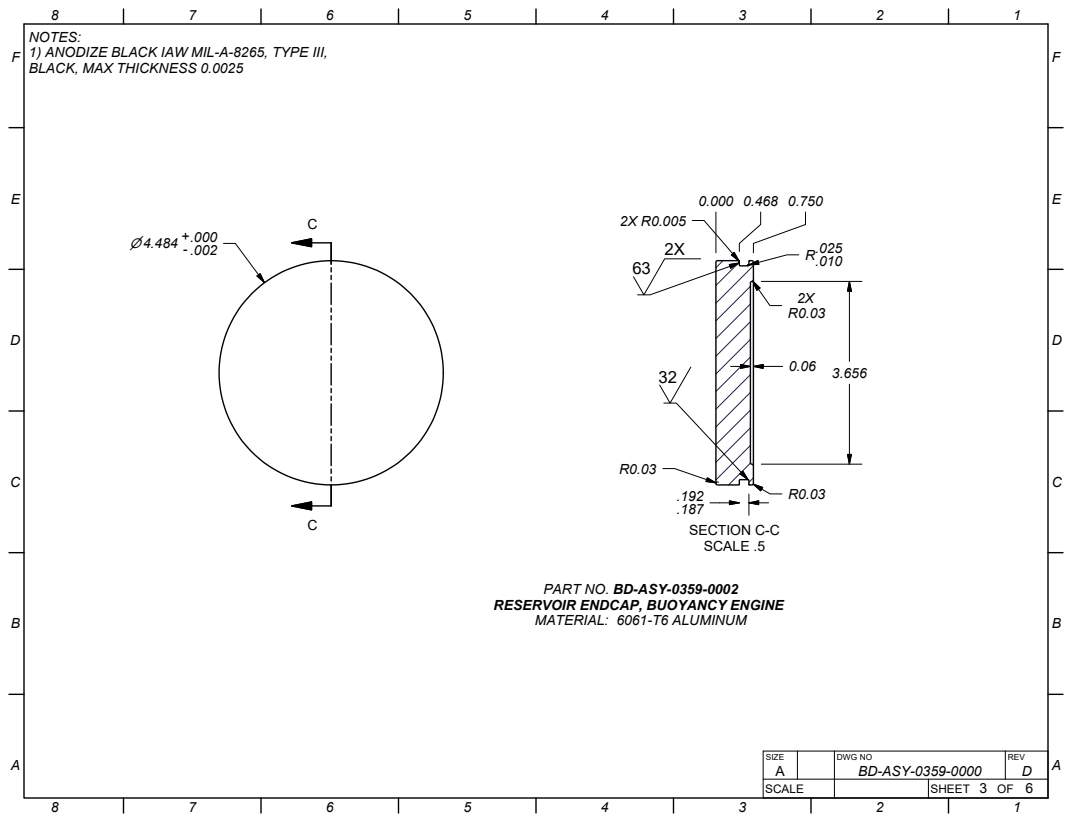
[picture p27: page 3]
SECTION C-C SCALE .5; SIZE; DWG NO; REV

1) ANODIZE BLACK IAW MIL-A-8265, TYPE III,
BLACK, MAX THICKNESS 0.0025

PART NO. BD-ASY-0359-0002

RESERVOIR ENDCAP, BUOYANCY ENGINE
MATERIAL: 6061-T6 ALUMINUM

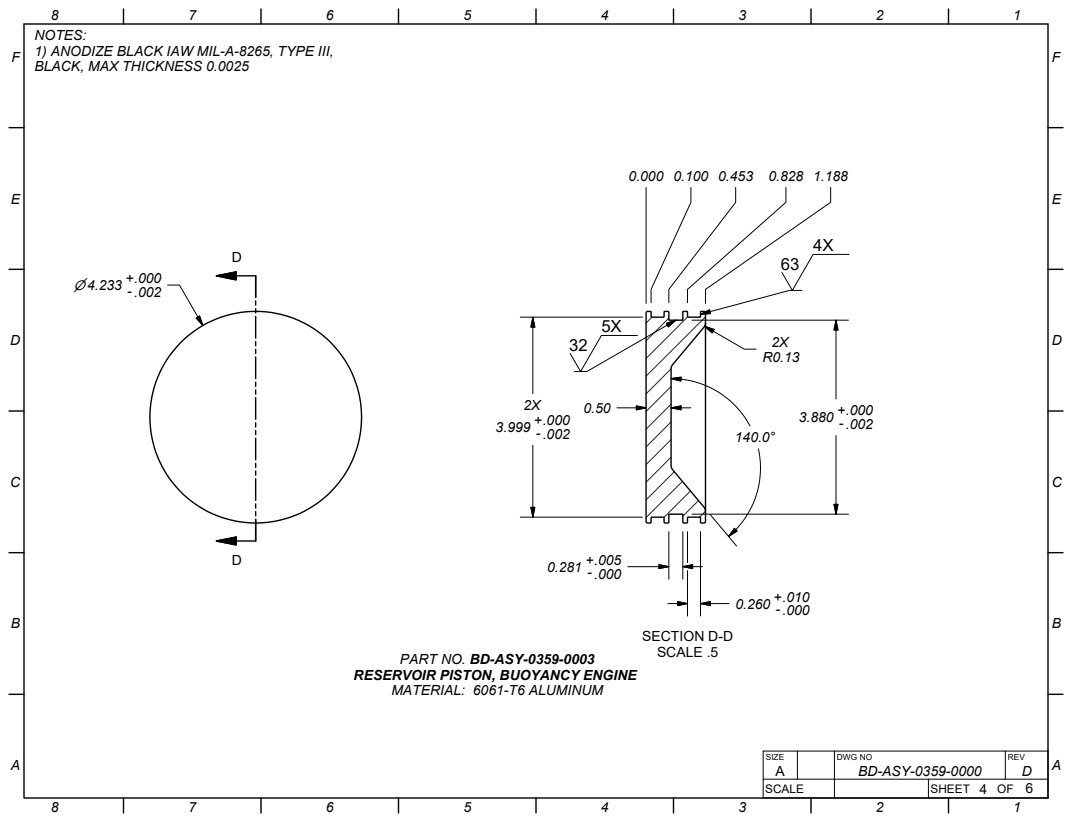
[picture p28: page 4]
SECTION D-D SCALE .5; SIZE; DWG NO; REV

1) ANODIZE BLACK IAW MIL-A-8265, TYPE III,
BLACK, MAX THICKNESS 0.0025

PART NO. BD-ASY-0359-0003

RESERVOIR PISTON, BUOYANCY ENGINE
MATERIAL: 6061-T6 ALUMINUM

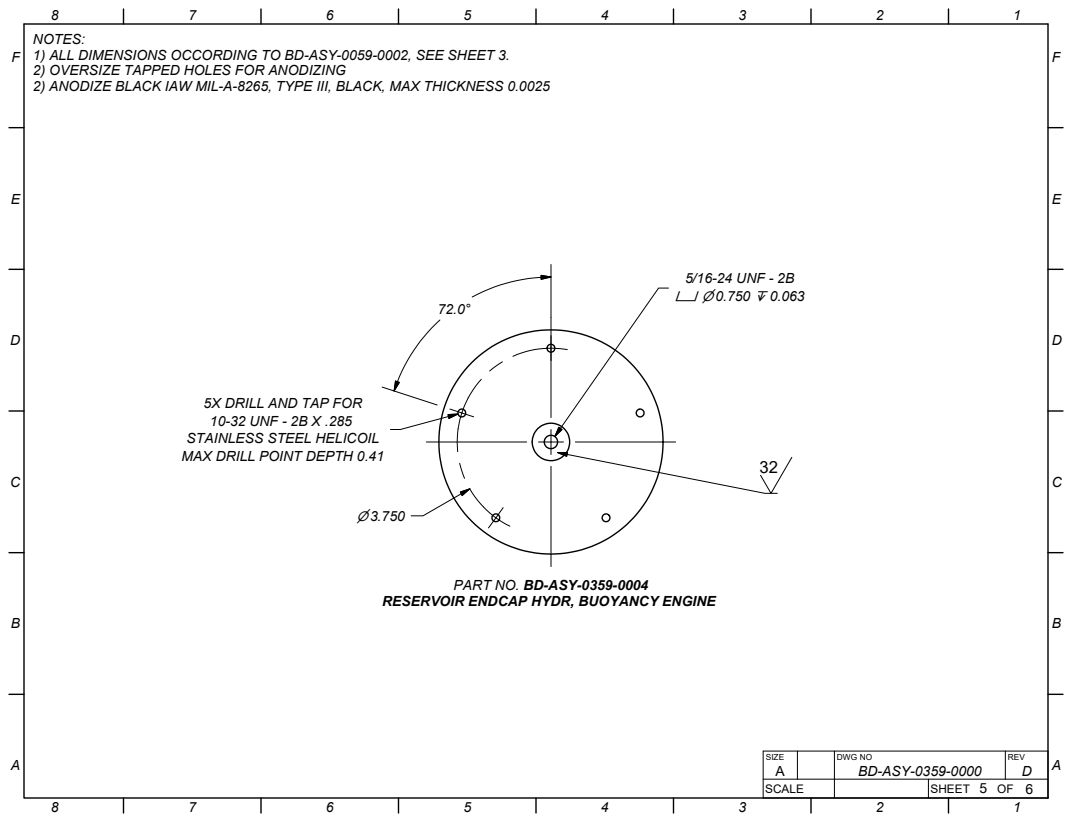
[picture p29: page 5]
SIZE; DWG NO; REV; 5/16-24 UNF - 2B 0.750 0.063

1) ALL DIMENSIONS OCCORDING TO BD-ASY-0059-0002, SEE SHEET 3.
2) OVERSIZE TAPPED HOLES FOR ANODIZING
2) ANODIZE BLACK IAW MIL-A-8265, TYPE III, BLACK, MAX THICKNESS 0.0025

5X DRILL AND TAP FOR
10-32 UNF - 2B X .285
STAINLESS STEEL HELICOIL
MAX DRILL POINT DEPTH 0.41

PART NO. BD-ASY-0359-0004

RESERVOIR ENDCAP HYDR, BUOYANCY ENGINE

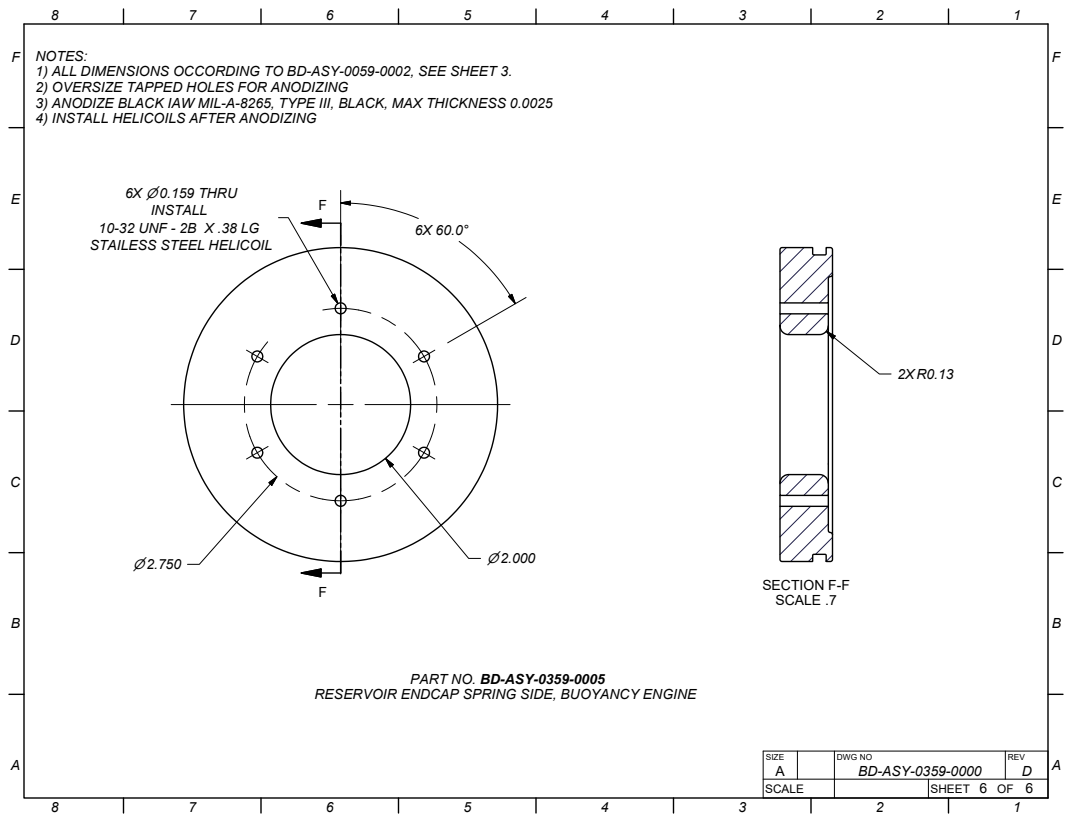
[picture p30: page 6]
SECTION F-F SCALE .7; SIZE; DWG NO; REV; 6X 0.159 THRU INSTALL

NOTES:
1) ALL DIMENSIONS OCCORDING TO BD-ASY-0059-0002, SEE SHEET 3.
2) OVERSIZE TAPPED HOLES FOR ANODIZING
3) ANODIZE BLACK IAW MIL-A-8265, TYPE III, BLACK, MAX THICKNESS 0.0025
4) INSTALL HELICOILS AFTER ANODIZING

10-32 UNF - 2B X .38 LG
STAILESS STEEL HELICOIL

PART NO. BD-ASY-0359-0005

RESERVOIR ENDCAP SPRING SIDE, BUOYANCY ENGINE
