SeaFlightGlider/seaflight-mechanical/BD-ASY-0360-0000_RevB.pdf

1

2

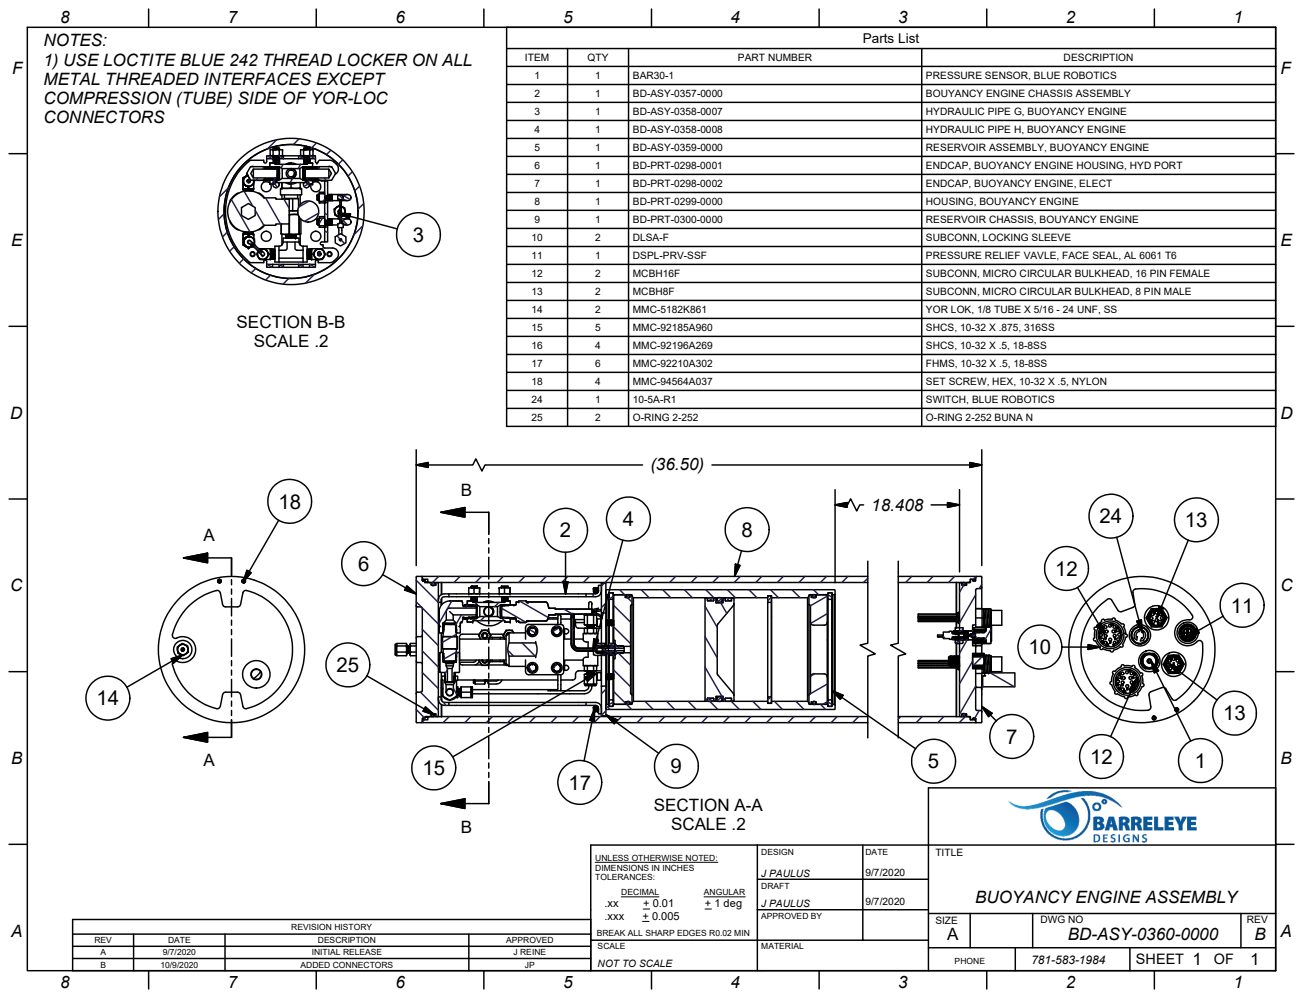
[picture p31: page 1]
SECTION A-A SCALE .2; SECTION B-B SCALE .2; SIZE; DWG NO; REV; SHEET; DESIGN; APPROVED BY; TITLE; DRAFT; DECIMAL; ANGULAR; + 1 deg; .xxx; MATERIAL; DATE; BD-ASY-0360-0000; J PAULUS; NOT TO SCALE; PHONE; Parts List; ITEM; QTY; PART NUMBER; DESCRIPTION; BAR30-1; PRESSURE SENSOR, BLUE ROBOTICS; BD-ASY-0357-0000; BOUYANCY ENGINE CHASSIS ASSEMBLY; BD-ASY-0358-0007; HYDRAULIC PIPE G, BUOYANCY ENGINE; BD-ASY-0358-0008; HYDRAULIC PIPE H, BUOYANCY ENGINE; BD-ASY-0359-0000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

UNLESS OTHERWISE NOTED:
DIMENSIONS IN INCHES
TOLERANCES:

BUOYANCY ENGINE ASSEMBLY

BREAK ALL SHARP EDGES R0.02 MIN
SCALE
