SeaFlightGlider/seaflight-mechanical/BD-PRT-0297-0000_RevC.pdf

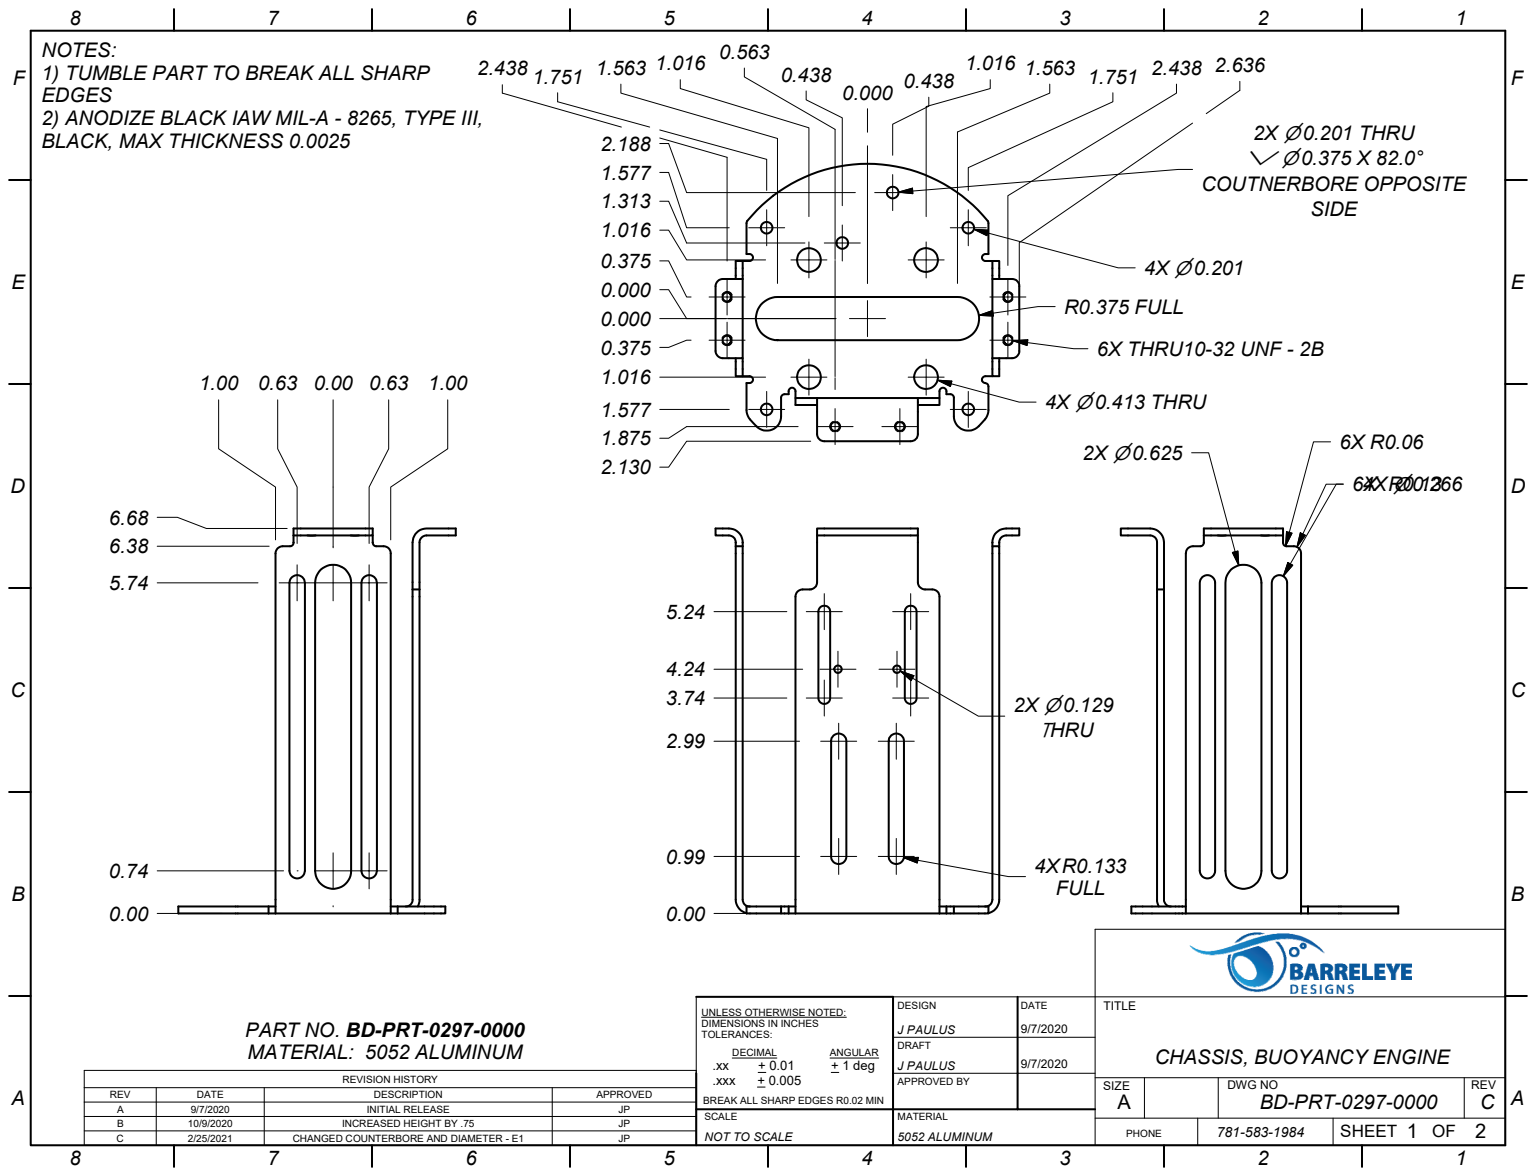
[picture p32: page 1]
SIZE; DWG NO; REV; SHEET; DESIGN; APPROVED BY; TITLE; DRAFT; DECIMAL; ANGULAR; + 1 deg; .xxx; MATERIAL; DATE; BD-PRT-0297-0000; J PAULUS; 5052 ALUMINUM; NOT TO SCALE; PHONE; REVISION HISTORY; INCREASED HEIGHT BY .75; CHANGED COUNTERBORE AND DIAMETER - E1; 6X THRU10-32 UNF - 2B; 2X 0.201 THRU 0.375 X 82.0° COUTNERBORE OPPOSITE SIDE; THRU 0.413; R0.375 FULL; 2X 0.129 HRU; 4XR0.133 FULL

NOTES:
1) TUMBLE PART TO BREAK ALL SHARP
EDGES
2) ANODIZE BLACK IAW MIL-A - 8265, TYPE III,
BLACK, MAX THICKNESS 0.0025

UNLESS OTHERWISE NOTED:
DIMENSIONS IN INCHES
TOLERANCES:

PART NO. BD-PRT-0297-0000
MATERIAL: 5052 ALUMINUM

CHASSIS, BUOYANCY ENGINE

REV | DATE | DESCRIPTION | APPROVED
A | 9/7/2020 | INITIAL RELEASE | JP

BREAK ALL SHARP EDGES R0.02 MIN
SCALE

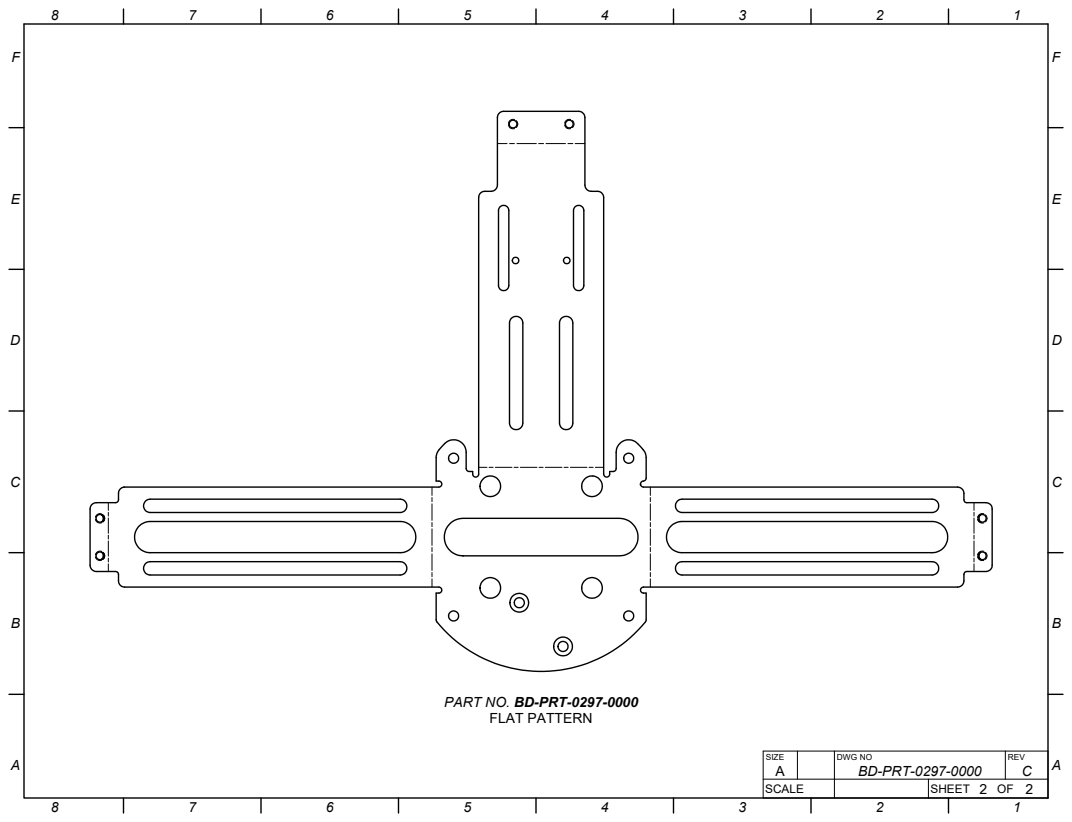
[picture p33: page 2]

PART NO. BD-PRT-0297-0000
FLAT PATTERN

SIZE A | DWG NO BD-PRT-0297-0000 | REV C

SCALE | SHEET 2 OF 2
