SeaFlightGlider/seaflight-mechanical/BD-PRT-0298-0000_RevE.pdf

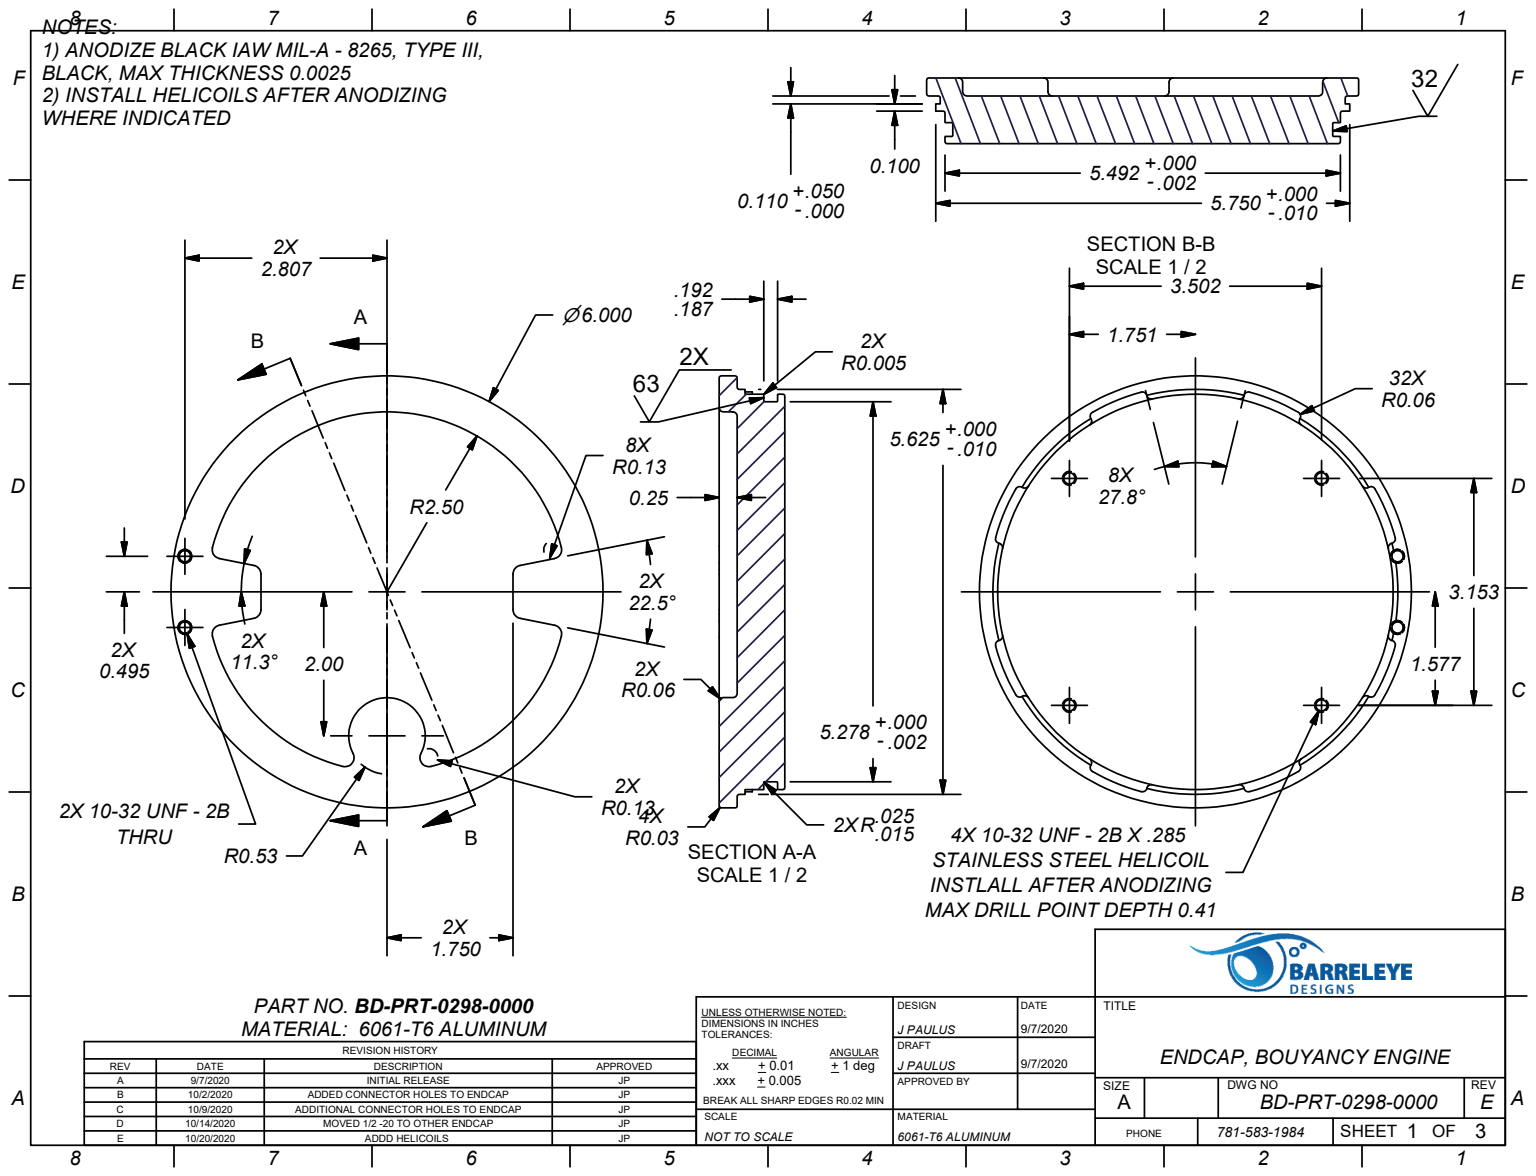
[picture p34: page 1]
SECTION A-A SCALE 1 / 2; SECTION B-B SCALE 1 / 2; SIZE; DWG NO; REV; SHEET; DESIGN; APPROVED BY; TITLE; DRAFT; DECIMAL; ANGULAR; + 1 deg; .xxx; MATERIAL; DATE; BD-PRT-0298-0000; J PAULUS; 6061-T6 ALUMINUM; NOT TO SCALE; PHONE; 2X 10-32 UNF - 2B THRU; REVISION HISTORY; DESCRIPTION; APPROVED; INITIAL RELEASE; MOVED 1/2 -20 TO OTHER ENDCAP; ADDD HELICOILS

NOTES:
1) ANODIZE BLACK IAW MIL-A - 8265, TYPE III,
BLACK, MAX THICKNESS 0.0025
2) INSTALL HELICOILS AFTER ANODIZING
WHERE INDICATED

4X 10-32 UNF - 2B X .285
STAINLESS STEEL HELICOIL
INSTLALL AFTER ANODIZING
MAX DRILL POINT DEPTH 0.41

PART NO. BD-PRT-0298-0000
MATERIAL: 6061-T6 ALUMINUM

UNLESS OTHERWISE NOTED:
DIMENSIONS IN INCHES
TOLERANCES:

ENDCAP, BOUYANCY ENGINE

B | 10/2/2020 | ADDED CONNECTOR HOLES TO ENDCAP | JP
C | 10/9/2020 | ADDITIONAL CONNECTOR HOLES TO ENDCAP | JP

BREAK ALL SHARP EDGES R0.02 MIN
SCALE

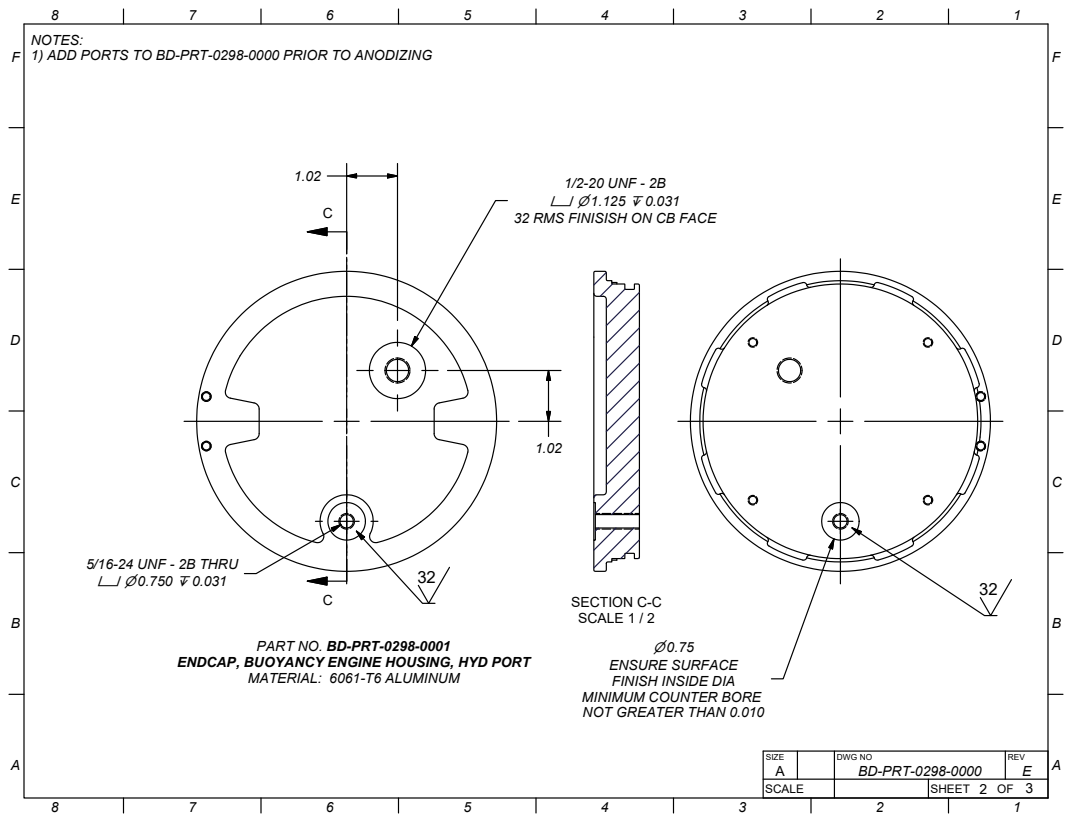
[picture p35: page 2]
MATERIAL: 6061-T6 ALUMINUM; SECTION C-C SCALE 1 / 2; 5/16-24 UNF - 2B THRU; 1/2-20 UNF - 2B

1) ADD PORTS TO BD-PRT-0298-0000 PRIOR TO ANODIZING

32 RMS FINISISH ON CB FACE

PART NO. BD-PRT-0298-0001

ENSURE SURFACE
FINISH INSIDE DIA
MINIMUM COUNTER BORE
NOT GREATER THAN 0.010

ENDCAP, BUOYANCY ENGINE HOUSING, HYD PORT

SIZE | DWG NO | REV

SCALE | SHEET OF

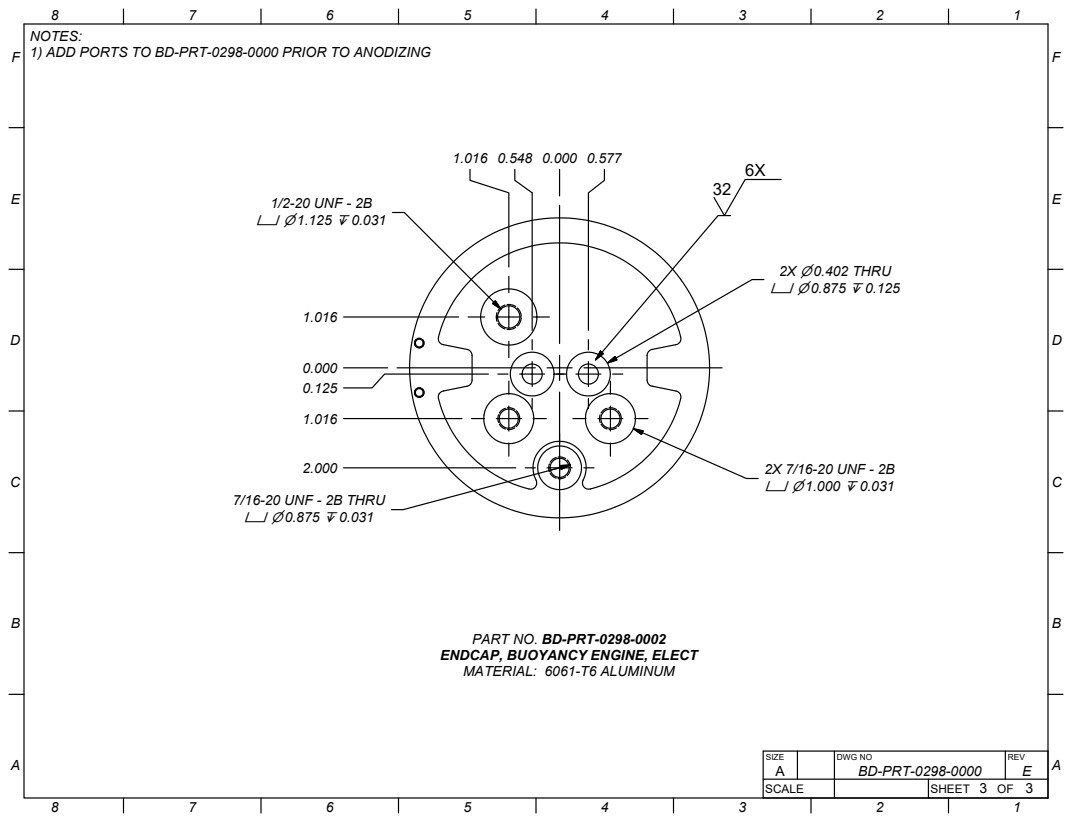
[picture p36: page 3]
7/16-20 UNF - 2B THRU 0.875 0.031; 1/2-20 UNF - 2B 1.125 0.031; 2X 7/16-20 UNF - 2B 1.000 0.031; 2X 0.402 THRU 0.875 0.125

1) ADD PORTS TO BD-PRT-0298-0000 PRIOR TO ANODIZING

PART NO. BD-PRT-0298-0002
ENDCAP, BUOYANCY ENGINE, ELECT
MATERIAL: 6061-T6 ALUMINUM

SIZE | DWG NO | REV

SCALE | SHEET OF
