SeaFlightGlider/seaflight-mechanical/BD-PRT-0299-0000_RevB.pdf

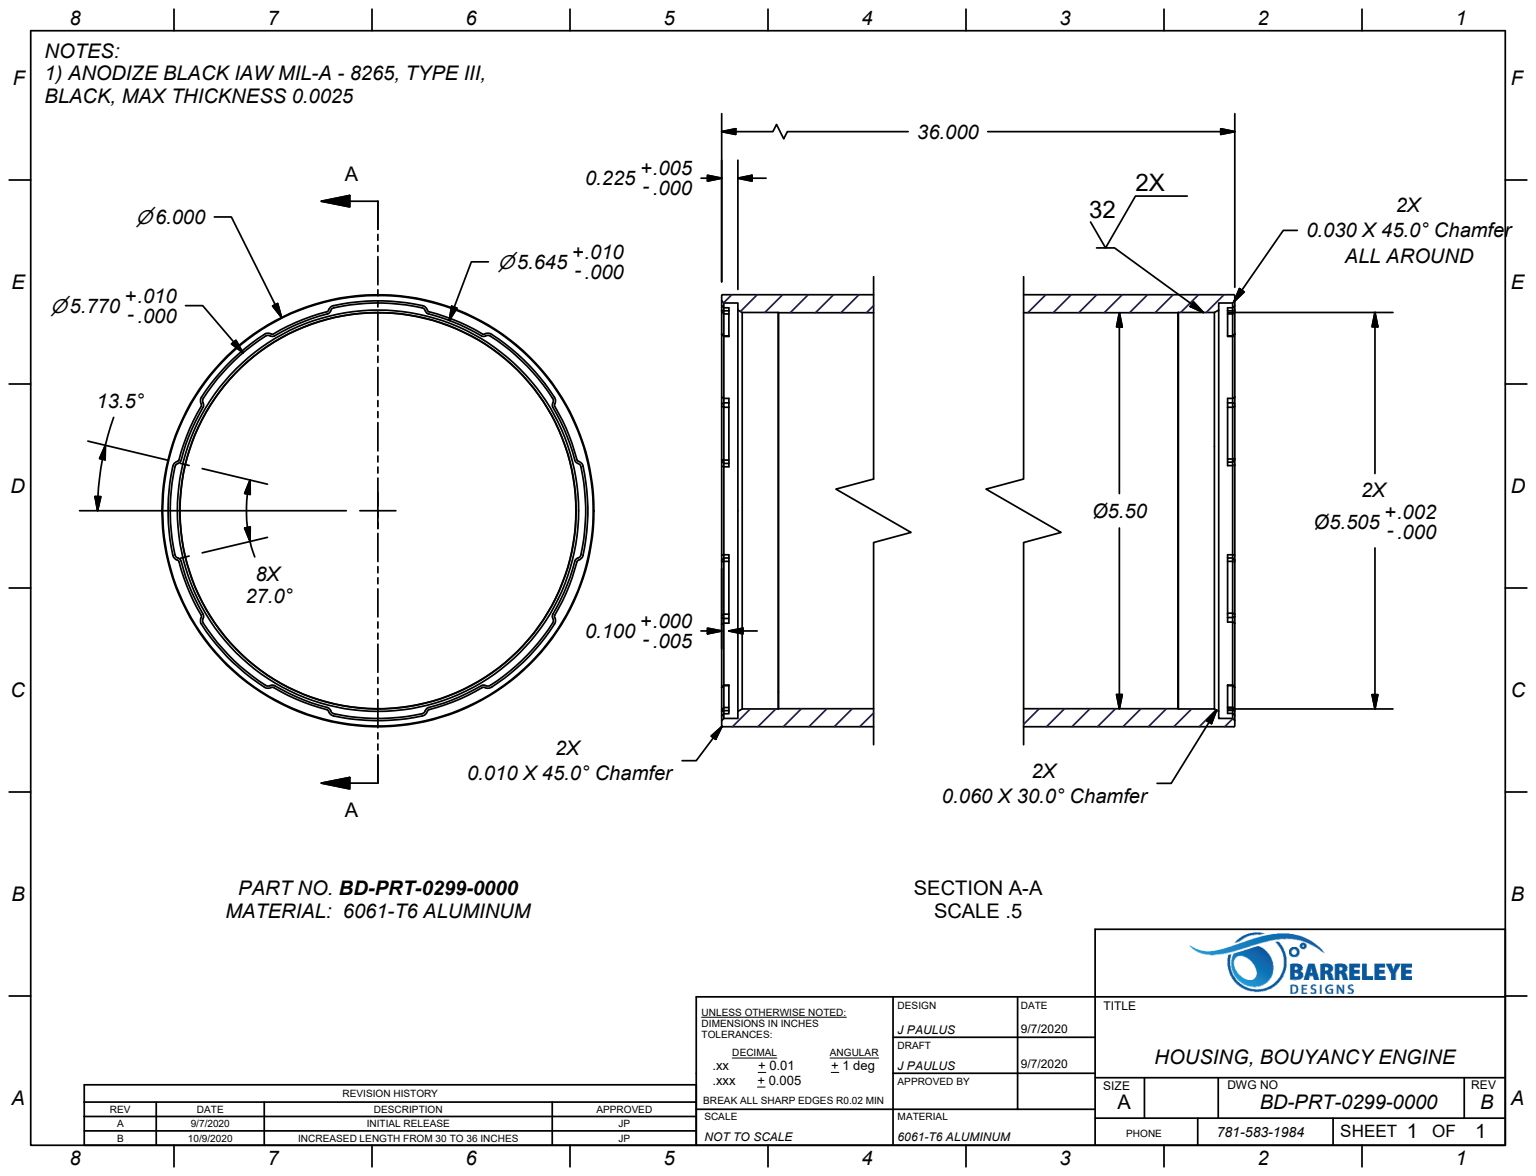
[picture p37: page 1]
SECTION A-A SCALE .5; SHEET; DESIGN; TITLE; DECIMAL; ANGULAR; + 1 deg; .xxx; MATERIAL; DATE; J PAULUS; 6061-T6 ALUMINUM; NOT TO SCALE; PHONE; 2X 0.060 X 30.0° Chamfer; 2X 0.030 X 45.0° Chamfer ALL AROUND; 2X 0.010 X 45.0° Chamfer; REVISION HISTORY; INITIAL RELEASE; INCREASED LENGTH FROM 30 TO 36 INCHES

NOTES:
1) ANODIZE BLACK IAW MIL-A - 8265, TYPE III,
BLACK, MAX THICKNESS 0.0025

PART NO. BD-PRT-0299-0000
MATERIAL: 6061-T6 ALUMINUM

UNLESS OTHERWISE NOTED:
DIMENSIONS IN INCHES
TOLERANCES:

DRAFT J PAULUS | 9/7/2020

HOUSING, BOUYANCY ENGINE

APPROVED BY | | SIZE A | DWG NO BD-PRT-0299-0000 | REV B

REV | DATE | DESCRIPTION | APPROVED

BREAK ALL SHARP EDGES R0.02 MIN
SCALE
