SeaFlightGlider/seaflight-mechanical/BD-PRT-0300-0000_RevB.pdf

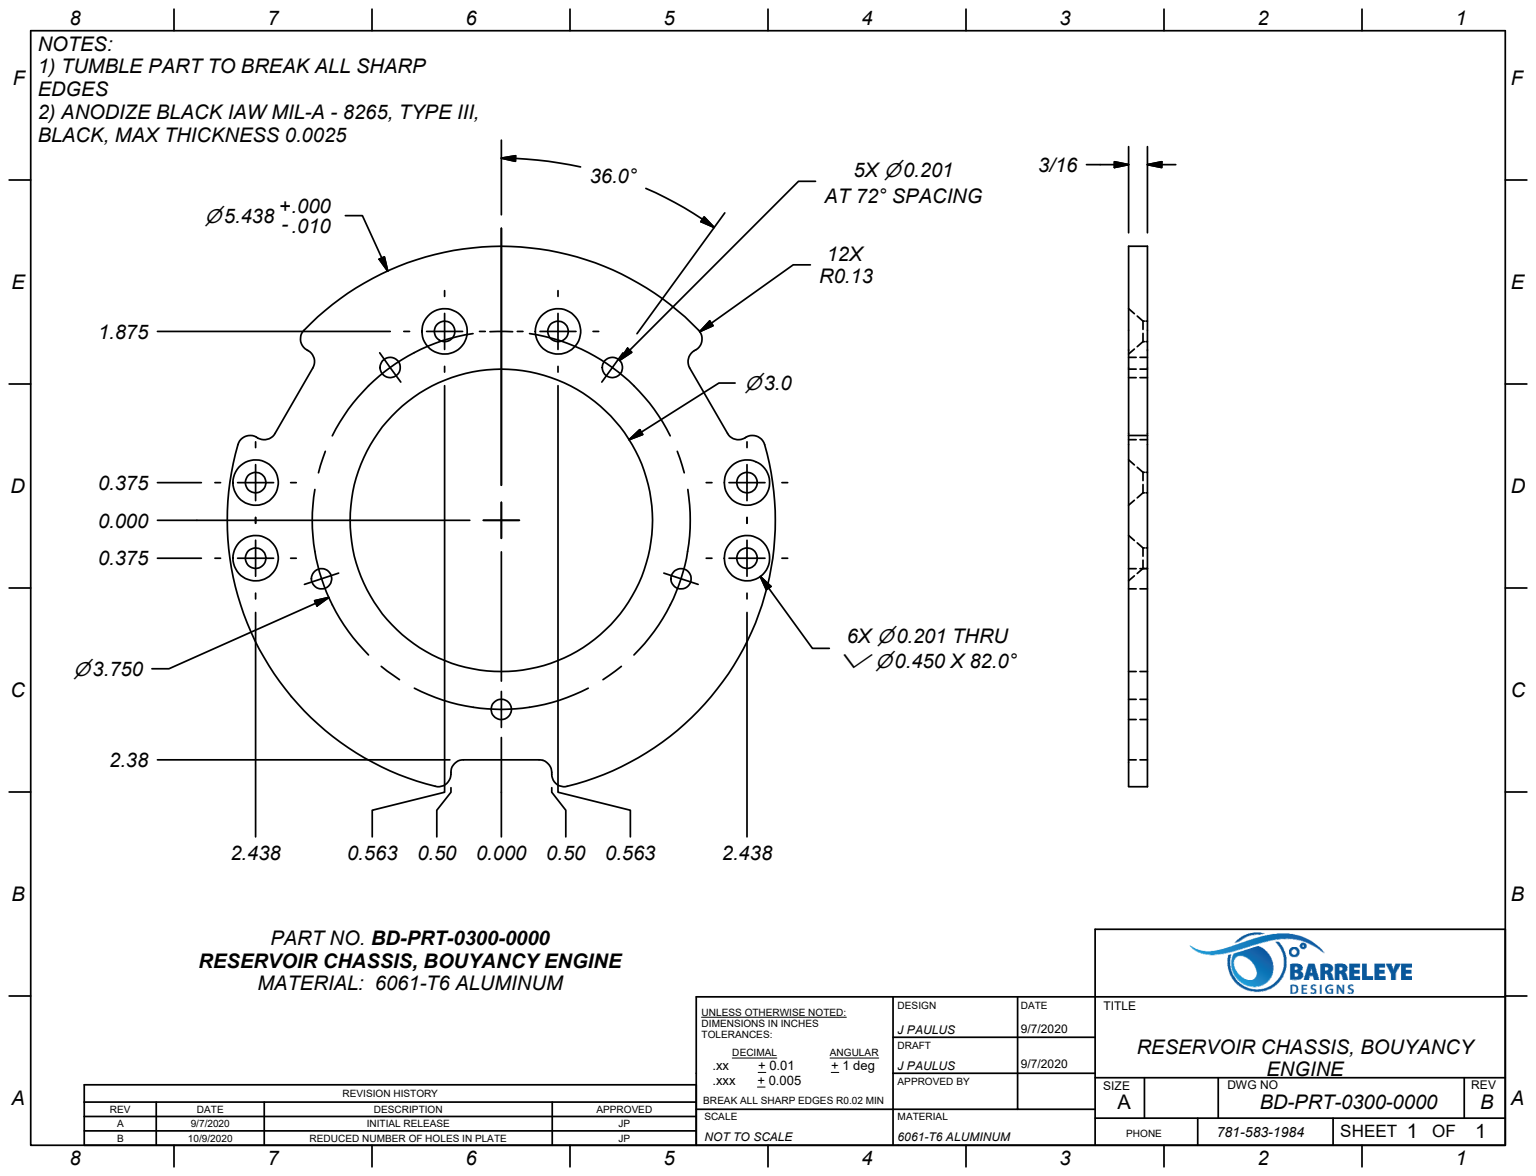
[picture p38: page 1]
SHEET; DESIGN; DECIMAL; ANGULAR; + 1 deg; .xxx; MATERIAL; DATE; ENGINE; J PAULUS; 6061-T6 ALUMINUM; NOT TO SCALE; PHONE; 6X 0.201 THRU 0.450 X 82.0°; 5X 0.201 AT 72° SPACING; REVISION HISTORY; INITIAL RELEASE; REDUCED NUMBER OF HOLES IN PLATE

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

PART NO. BD-PRT-0300-0000

RESERVOIR CHASSIS, BOUYANCY ENGINE
MATERIAL: 6061-T6 ALUMINUM

UNLESS OTHERWISE NOTED:
DIMENSIONS IN INCHES
TOLERANCES:

TITLE
RESERVOIR CHASSIS, BOUYANCY

DRAFT J PAULUS | 9/7/2020

APPROVED BY | | SIZE A | DWG NO BD-PRT-0300-0000 | REV B

REV | DATE | DESCRIPTION | APPROVED

BREAK ALL SHARP EDGES R0.02 MIN
SCALE
